Max-Westerman/Integration-Final-Report/main.tex

\documentclass[11pt]{report}
\usepackage{StyleSheets/main}
\makeglossaries               % Only makes glossary in main file
\usetikzlibrary{external}     % Allows for cached complitation
\tikzexternalize[prefix=Graphs/tikz/] % Sets cache directory
\begin{document}
\input{Chapters/TitlePage}

% ---------- %

\microtypesetup{protrusion=false} % Kerning disabled
\singlespacing
\tableofcontents
\listoffigures
\lstlistoflistings
\listoftables
\microtypesetup{protrusion=true} % Kerning Enabled

\newpage
\onehalfspacing

\input{Chapters/Introduction}
\input{Chapters/Project Management Plan}
\input{Chapters/System Requirements}
\input{Chapters/CONOPS}
\input{Chapters/Conceptual Design}
\input{Chapters/System Risk Management}
\input{Chapters/Detailed Design}
\input{Chapters/System Test and Verification}
\input{Chapters/System Analysis}
\input{Chapters/Summary}

\singlespacing
\microtypesetup{protrusion=false} % Kerning disabled
\printglossary[type=\acronymtype]
\input{Chapters/Documentation and Acknowledgements}
\microtypesetup{protrusion=true}  % Kerning Enabled

\appendix
\input{Appendix/Calibration Data}
\input{Appendix/Diagrams}
\input{Appendix/Code}

\end{document}
