Max-Westerman/Integration-Final-Report/Appendix/Diagrams.tex

\documentclass[12pt]{report}
\usepackage{StyleSheets/main}
\begin{document}

\chapter{Diagrams}\label{ap:diagrams}

\section{Robot Designs}
\label{sc:designs}

\begin{figure}[H]
    \centering
    
    \caption{Design 1 Conceptual Design}
    \label{fig:design1}
\end{figure}

\begin{figure}[H]
    \centering
    
    \caption{Design 2 Conceptual Design}
    \label{fig:design2}
\end{figure}

\begin{figure}[H]
    \centering
    
    \caption{Design 3 Conceptual Design}
    \label{fig:design3}
\end{figure}

\begin{figure}[H]
    \centering
    
    \caption{Design 4 Conceptual Design}
    \label{fig:design4}
\end{figure}

\section{Robot Images}

\begin{figure}[H]
    \centering
    
    \caption{Robot front view}
    \label{fig:front-view}
\end{figure}

\begin{figure}[H]
    \centering
    
    \caption{Robot underside}
    \label{fig:underside}
\end{figure}

\begin{figure}[H]
    \centering
    
    \caption{Robot top view}
    \label{fig:topview}
\end{figure}

\section{3D Printed Parts}
\begin{figure}[H]
    \centering
    
    \caption{Front Ultrasonic Sensor Mount}
    \label{fig:USS_front}
\end{figure}
\begin{figure}[H]
    \centering
    
    \caption{Color Sensor \& IR Sensor Mount}
    \label{fig:CS-IR mount}
\end{figure}

\begin{figure}[H]
    \centering
    
    \caption{Gripper Color Sensor Mount}
    \label{fig:GRPR_CS}
\end{figure}

\begin{figure}[H]
    \centering
    
    \caption{Gripper Button Mount}
    \label{fig:GRPR_DualButton}
\end{figure}

\begin{figure}[H]
    \centering
    
    \caption{Ultrasonic Sensor and Color Sensor Mounts}
    \label{fig:USS-CS_Dual}
\end{figure}

\begin{figure}[H]
    \centering
    
    \caption{Cost of first 3D-print}
    \label{fig:printcost1}
\end{figure}

\begin{figure}[H]
    \centering
    
    \caption{Cost of second 3D-print}
    \label{fig:printcost2}
\end{figure}

\begin{figure}[H]
    \centering
    
    \caption{Cost of third 3D-print}
    \label{fig:printcost3}
\end{figure}

\begin{figure}[H]
    \centering
    
    \caption{Cost of the \gls{IR} sensor array}
    \label{fig:enter-label}
\end{figure}

\section{Electrical Diagrams}
\subsection{Circuit Diagram}
\begin{figure}[H]
    \centering
    
    \caption{Circuit Diagram}
    \label{fig:CircuitDiagram}
\end{figure}

\subsection{Pinout Map for Teensy 4.1}
\begin{figure}[H]
    \centering
    
    \caption{Teensy 4.1 Microcontroller Pinout Map}
    \label{fig:Pinoutmap}
\end{figure}

\section{Pickup \& Place Flowchart}\label{sc:pickup-place-flowchart}

\begin{figure}[H]
    \centering
    
    \caption{PID Line Following Function}
    \label{fig:fc:pid_line_following}
\end{figure}

\begin{figure}[H]
    \centering
    
    \caption{Translational Line Centering Function}
    \label{fig:fc:translational-line-centering}
\end{figure}

\begin{figure}[H]
    \centering
    
    \caption{Rotational Line Centering Function}
    \label{fig:fc:rotational-line-centering}
\end{figure}

\begin{figure}[H]
    \centering
    
    \caption{Beginning of Pickup \& Place}
    \label{fig:fc:begin}
\end{figure}

\begin{figure}[H]
    \centering
    
    \caption{Line Orientation Sub Module}
    \label{fig:fc:line-orientation}
\end{figure}

\begin{figure}[H]
    \centering
    
    \caption{Middle Navigation Sub Module}
    \label{fig:fc:middle-navigation}
\end{figure}

\begin{figure}[H]
    \centering
    
    \caption{Fork Navigation Sub Module}
    \label{fig:fc:fork-navigation}
\end{figure}

\begin{figure}[H]
    \centering
    
    \caption{Find Platform Sub Module}
    \label{fig:fc:find-platform}
\end{figure}

\begin{figure}[H]
    \centering
    
    \caption{Navigate Back to Fork Sub Module}
    \label{fig:fc:navigate-back-to-fork}
\end{figure}

\begin{figure}[H]
    \centering
    
    \caption{Return Home Sub Module}
    \label{fig:fc:return-home}
\end{figure}

\newpage\section{Pickup-and-Place Line Course}
\begin{figure}[H]
    \centering
    
    \caption{Pickup-and-Place course.\protect\footnotemark}
    \label{fig:pickup-place-course}
\end{figure}
\footnotetext{Note that within the vertical, green lines are the boundaries of the randomized region of the course.}

\end{document}

    
    \caption{Circuit Diagram}
