Max-Westerman/Integration-Final-Report/Chapters/TitlePage.tex

\documentclass[11pt]{report}
\usepackage{StyleSheets/main}
\usetikzlibrary{external}     % Allows for cached complitation
\tikzexternalize[prefix=Graphs/tikz/] % Sets cache directory

\begin{document}

\begin{titlepage}

    \tikzset{external/export next=false} % Exclude from externalization
    \begin{tikzpicture}[remember picture, overlay]
        \node[anchor=south east, inner sep=0, opacity=0.1, xshift=100mm, yshift=35mm] at (current page.south east) {
              % Adjust only width or height
        };
    \end{tikzpicture}
    
    \centering
    
    \Large{ENGR 2620}
    
    \Large{Integration II}
    
    \Large{Spring 2024}

    \vspace{0.5cm}
    
    \Huge \textsc{\TITLENAME}

    \vfill
    
    \vspace{1cm}
    
    \large{Dr. Jide Williams} \\
    \large{Dr. Irwin Jones}
    
    \vspace{0.8cm}

    \large \textbf{Prepared By:}
    \hspace{1.3cm} \begin{tabular}[t]{@{}l@{}}
        \textbf{Max Westerman}\\
        \textbf{Daniel Carey}\\
        \textbf{Charlie Buttrick}\\
        \textbf{Dylan Wright}\\
    \end{tabular}
    \vspace{10pt}
    
    \vfill
    \hfill \large Report Grade: \underline{\hspace{4cm}}
        
\end{titlepage}

\end{document}

    \begin{tikzpicture}[remember picture, overlay]
        \node[
            anchor=north west,
            fill=gray!20,
            minimum width=\paperwidth,
            minimum height=4cm,
            yshift=-17.35cm,
            xshift = 10.7cm
        ] at (current page.north west) {};
    \end{tikzpicture}
