Max-Westerman/Integration-Final-Report/Chapters/Project Management Plan.tex

\documentclass[11pt]{report}
\usepackage{StyleSheets/main}

\begin{document}

\SectionuseSubSectionSizing
\SubSectionuseSubSubSectionSizing
\setlength{\parindent}{0pt} % Disables indentation

\chapter{Project Management Plan}\label{ch:project-management-plan}

\section{Week 1 (4/1/24 - 4/7/24)}
\begin{adjustwidth}{0.5cm}{0cm}
\subsection*{4/4}
\begin{greylineformat}
\begin{description}
    \item [50 minutes] Danny Carey and Charlie Buttrick looked over the provided kits and used the material checklist to verify all materials for the project were missing.
    \item [25 minutes] Danny Carey and Charlie Buttrick test ultrasonic sensors.
\end{description}\end{greylineformat}

\begin{description}
    \item [Weekly Summary:] Provided kits were checked and materials were verified. Ultrasonic Sensors were tested. Our objectives for next week will be to meet with Carter Sorenson and begin to talk about ideas for the obstacle test.
\end{description}\vspace{0.5em}
\end{adjustwidth}

\section{Week 2 (4/8/24 - 4/14/24)}
\begin{adjustwidth}{0.5cm}{0cm}
\subsection*{4/8}
\begin{greylineformat}
\begin{description}
    \item [25 minutes]Danny Carey, Charlie Buttrick, and Max Westerman met to discuss the outline of the code. The idea to use classes was commonly agreed it would be most efficient due to making troubleshooting easier.
\end{description}\end{greylineformat}

\vspace{-2.1em}\subsection*{4/11}
\begin{greylineformat}
\begin{description}
    \item [60 minutes]Charlie Buttrick and Max Westerman met with Carter Sorenson for advice on the overall strategy of the project. The meeting also covered the subject of \gls{PID} controllers.
    \item [1 hour and 30 minutes]Charlie Buttrick worked on pseudo-code for the obstacle test.
    \item [1 hour]Danny Carey began to work on the gripper, specifically a prototype design.
    \item [1 hour] Danny Carey and Max Westerman brainstormed ideas for the overall design of the vehicle, with a targeted focus on wheel placement.
\end{description}\end{greylineformat}

\begin{description}
    \item [Weekly Summary:]The outline of the code was decided on. A project strategy was created, and \gls{PID} controllers were discussed. Pseudo-code written for obstacle test. A gripper prototype was designed. Wheel placement was discussed. Our objectives for next week will be to begin the design of the vehicle and simple movement testing.
\end{description}
\end{adjustwidth}\vspace{0.5em}

\section{Week 3 (4/15/24 - 4/21/24)}
\begin{adjustwidth}{0.5cm}{0cm}
\subsection*{4/15}
\begin{greylineformat}
\begin{description}
    \item [35 minutes] Max Westerman worked on color sensors and added debug statements. 
    \item [1 hour and 45 minutes] Danny Carey and Max Westerman assembled wheels, motor controllers, and Teensy 4.1 board for design 1. 
\end{description}\end{greylineformat}

\vspace{-2.1em}\subsection*{4/16}
\begin{greylineformat}
\begin{description}
    \item [1 hour] Max Westerman ran a motor test for design 1. 
    \item [25 minutes] Max Westerman tested the resistance of black and silver screws that will be used to connect the battery and motor controller. 
\end{description}\end{greylineformat}

\vspace{-2.1em}\subsection*{4/18}
\begin{greylineformat}
\begin{description}
    \item [1 hour and 30 minutes] Danny Carey continued work on the gripper arm and began to add wiring. 
    \item [1 hour] Charlie Buttrick and Max Westerman brainstormed ideas for code of the obstacle course and the location of the ultrasonic sensors on the vehicle. 
    \item [30 minutes] Charlie Buttrick and Max Westerman thought of ideas to fix side wheels that were stalling on forward movement. 
\end{description}\end{greylineformat}

\begin{description}
    \item [Weekly Summary:]Debug statements added to code. Wheels assembled with motor controllers and Teensy 4.1 for design 1. Motor test conducted. Resistance of screws tested for battery connection. Gripper wiring added. Obstacle code and ultrasonic sensor location discussed. Ideas to fix side wheels that were stalling generated. Our objectives for next week will be to work on our detailed design presentation and continue to build system, specifically the placement of the ultrasonic sensors.
\end{description}\vspace{0.5em}
\end{adjustwidth}

\section{Week 4 (4/22/24 - 4/28/24)}
\begin{adjustwidth}{0.5cm}{0cm}
\subsection*{4/23}
\begin{greylineformat}
\begin{description}
    \item [1 hour] Danny Carey and Charlie Buttrick began to work on detailed design review. 
    \begin{dash-itemize}
        \item Charlie Buttrick focused more on customer requirements, the project management plan, the purpose, and the current state of the project.
        \item Danny Carey focused on the project design outline, the design matrix, and the current state of the project.
    \end{dash-itemize}
\end{description}\end{greylineformat}

\vspace{-2.1em}\subsection*{4/25}
\begin{greylineformat}
\begin{description}
    \item [35 minutes] Danny Carey and Charlie Buttrick moved ultrasonic sensors to the front of the vehicle. 
    \item [30 minutes] Danny Carey and Charlie Buttrick added washers to the side wheels to try to fix the side wheels from stalling. 
    \item [35 minutes] Danny Carey and Charlie Buttrick took apart Design 1, specifically the wiring and placement of the battery. The motor controllers and wheels are still intact. 
    \item [20 minutes] Dylan Wright, Danny Carey, and Charlie Buttrick gave detailed design review presentation.
\end{description}\end{greylineformat}

\begin{description}
    \item [Weekly Summary:] Detailed design review started. Ultrasonic sensors are placed in front of vehicles. Washers were placed under side wheels to try to fix stalling. Design 1 deconstructed (wiring/battery). Detailed design presentation takes place and feedback is given. Our objectives for next week will be to begin writing the obstacle code and discuss the line following code.
\end{description}\vspace{0.5em}
\end{adjustwidth}

\section{Week 5 (4/29/24 - 5/5/24)}
\begin{adjustwidth}{0.5cm}{0cm}
\subsection*{4/30}
\begin{greylineformat}
\begin{description}
    \item [1 hour] Charlie Buttrick and Max Westerman met to discuss and begin code for obstacle course test, specifically adding classes to the code for more scenarios. 
    \item [30 minutes] Charlie Buttrick and Max Westerman discussed the line following code. 
\end{description}\end{greylineformat}

\vspace{-2.1em}\subsection*{5/2}
\begin{greylineformat}
\begin{description}
    \item [2 hours] It was discovered that after Design 1 was taken apart, multiple wire tips were disconnected and broken.
    \begin{dash-itemize}
        \item Charlie Buttrick tried to solder back one wire to the motor and accidentally burned the motor. The team bought a new motor.
        \item Max used equipment in the innovation lab to solder back the wires to the motors and motor controllers.
    \end{dash-itemize}
    \item [1 hour] Charlie Buttrick added to the ultrasonic code. 
    \item [1 hour and 30 minutes] Danny Carey began to build Design 2, focused on the placement of the battery and Teensy 4.1 board. Also, added wiring for the Teensy 4.1 board and battery. 
\end{description}\end{greylineformat}

\vspace{0.1em}\begin{description}
    \item [Weekly Summary:] Obstacle avoidance and line following code discussed. Multiple damages and breakages were discovered after Design 1 was deconstructed. Soldering was attempted but the motor broke. New motor was burnt and the innovation lab was used to solder wires. Ultrasonic code improved. Design 2 was built, battery placement and Teensy 4.1 placement and wiring focus. Our objectives for next week will be to test our obstacle avoidance code and make progress with building the gripper. Another objective will be to complete the gripper wiring for the gripper and test design 2 on the obstacle course.
\end{description}\vspace{0.5em}
\end{adjustwidth}

\section{Week 6 (5/6/24 - 5/12/24)}
\begin{adjustwidth}{0.5cm}{0cm}
\subsection*{5/7}
\begin{greylineformat}
\begin{description}
    \item [30 minutes] Charlie Buttrick, Danny Carey, and Max Westerman combined the motor controller plate and battery/Teensy 4.1 board plate. 
    \item [30 minutes] Charlie Buttrick, Danny Carey, and Max Westerman placed sensor mounts on the front of the vehicle and attached ultrasonic sensors. 
    \item [25 minutes] Charlie Buttrick and Max Westerman verified the ultrasonic sensor code. 
\end{description}\end{greylineformat}

\vspace{-2.1em}\subsection*{5/9}
\begin{greylineformat}
\begin{description}
    \item [1 hour and 40 minutes] Charlie Buttrick, Danny Carey, Dylan Wright, and Max Westerman tested the obstacle test. 
\end{description}\end{greylineformat}

\vspace{-2.1em}\subsection*{5/10}
\begin{greylineformat}
\begin{description}
    \item [1 hour and 40 minutes] Danny Carey and Max Westerman completed the wiring for the gripper. 
\end{description}\end{greylineformat}

\vspace{-2.1em}\subsection*{5/12}
\begin{greylineformat}
\begin{description}
    \item [1 hour and 30 minutes] Charlie Buttrick and Max Westerman tried to fix the side wheels' stalling issue by adding heavy mass to the vehicle. 
    \item [10 minutes] Charlie Buttrick, Danny Carey, and Max Westerman decided to take apart Design 2.
    \item [1 hour] Danny Carey builds customized sensor mounts in SolidWorks. 
    \item [1 hour] Max Westerman takes apart all of Design 2 except the motor controller and wheel placement and wires. 
    \item [35 minutes] Charlie Buttrick and Max Westerman think about the idea of IR sensors. 
\end{description}\end{greylineformat}

\newpage
\begin{description}
    \item [Weekly Summary:]Motor controller plate and battery/Teensy 4.1 plate combined. Sensor mounts and ultrasonic sensors are attached. Ultrasonic sensor code verified. Obstacle course run tested. Wiring for gripper completed. Heavy mass was added to the vehicle to fix the side wheels stalling. Design 2 taken apart. Customized sensor mounts built in SolidWorks. \gls{IR} sensor idea discussed. Our objectives for next week will be to test redesign Design 3 as well as test the gearboxes to see if they will or will not impact the speed. Also, sensor mounts will be printed for the ultrasonic sensors. We will also want to finish the line following code and begin testing and implement the \gls{IR} Array.
\end{description}\vspace{0.5em}
\end{adjustwidth}

\section{Week 7 (5/13/24 - 5/19/24)}
\begin{adjustwidth}{0.5cm}{0cm}
\subsection*{5/13}
\begin{greylineformat}
\begin{description}
    \item [10 minutes] Danny Carey 3-D prints sensor mounts for Design 3. 
    \item [30 minutes] Max Westerman tests the compatibility of gearboxes for torque motors. It is deemed successful thus 2 motors of the vehicle are replaced. 
    \item [3 hours] Max Westerman machined down a dead torque motor gearbox. This verified that the torque motor would be faster when modified. 
\end{description}\end{greylineformat}

\vspace{-2.1em}\subsection*{5/14}
\begin{greylineformat}
\begin{description}
    \item [2 hours and 30 minutes] Danny Carey and Max Westerman assembled Design 3, the plate with the motor controllers and wheels are attached to the plate with the Teensy 4.1 board as well as the battery. 
\end{description}\end{greylineformat}

\vspace{-2.1em}\subsection*{5/16}
\begin{greylineformat}
\begin{description}
    \item [40 minutes] Danny Carey attaches the customized sensor mounts to the vehicle and the color and ultrasonic sensors are attached. 
    \item [1 hour and 30 minutes] Charlie Buttrick, Dylan Wright, Danny Carey, and Max Westerman test Design 3 on the obstacle test. 
    \item [35 minutes] Charlie Buttrick and Max Westerman test the basic line following code. 
    \item [1 hour] Danny Carey designed a sensor mount for the bottom of the vehicle. 
\end{description}\end{greylineformat}

\vspace{-2.1em}\subsection*{5/19}
\begin{greylineformat}
\begin{description}
    \item [1 hour] Danny Carey and Max Westerman attach the gripper to the vehicle. 
    \item [1 hour and 30 minutes] Danny Carey and Max Westerman attach an \gls{IR} array and color sensor to the sensor mount on the bottom of the vehicle. 
\end{description}\end{greylineformat}

\newpage
\begin{description}
    \item [Weekly Summary:]Sensor mounts for Design 3 printed. Compatibility of gearboxes for torque motors tested. 2 motors are replaced. Design 3 is assembled. Sensor mounts are attached. Design 3 tested on an obstacle test. Basic line following code tested. Sensor mount for bottom of vehicle designed. Gripper attached to the vehicle. \gls{IR} and color sensor attached to the vehicle. Our objectives for next week will be to clean up the wiring of the system, add pushbuttons to the end of the gripper arm, continue obstacle testing, test the line following code and improve the vehicle’s ability to follow the line as needed.
\end{description}\vspace{0.5em}
\end{adjustwidth}

\section{Week 8 (5/20/24 - 5/26/24)}
\begin{adjustwidth}{0.5cm}{0cm}
\subsection*{5/20}
\begin{greylineformat}
\begin{description}
    \item [1 hour and 20 minutes] Danny Carey and Max Westerman rewired the color sensors, the gripper, the \gls{IR} array, and the ultrasonic sensor. 
    \item [30 minutes] Danny Carey and Max Westerman implemented, coded, and wired the button toggle for the gripper. 
    \item [1 hour and 30 minutes] Danny Carey and Max Westerman secured the plastic gripper gear via reversible super glue and lock tight. 
    \item [1 hour] Max Westerman coded the gripper pick-up and place schema and tested. The middle color sensor is burnt.
    \item [2 hours] Max Westerman tested obstacle avoidance. 
    \item [3 hours] Max Westerman designed and implemented a suspension system on the vehicle. 
\end{description}\end{greylineformat}

\vspace{-2.1em}\subsection*{5/21}
\begin{greylineformat}
\begin{description}
    \item [1 hour and 25 minutes] Max Westerman implemented the suspension system. 
    \item [1 hour] Max Westerman and Charlie Buttrick began to code the \gls{IR} array algorithm as well as brainstorm how to implement \gls{PID} logic. 
    \item [1 hour and 10 minutes] Max Westerman worked on pick-up and placement code for the system. 
    \item [45 minutes] Danny Carey redesigned sensor mounts for the front of the vehicle after it was discovered it cracked. 
    \item [2 hours] Max Westerman and Charlie Buttrick worked on and tested the line following code. 
    \item [25 minutes] Danny Carey replaced the middle burnt color sensor. 
\end{description}\end{greylineformat}

\vspace{-2.1em}\subsection*{5/22}
\begin{greylineformat}
\begin{description}
    \item [1 hour] Danny Carey designed a mount for the end of the gripper arm via SolidWorks. 
    \item [2 hours] Danny Carey and Max Westerman continued to wire the gripper as sensors and pushbuttons were being added. 
\end{description}\end{greylineformat}

\vspace{-2.1em}\subsection*{5/23}
\begin{greylineformat}
\begin{description}
    \item [1 hour] Danny Carey and Charlie Buttrick attached a new sensor mount to the bottom side of the front end of the vehicle. 
    \item [1 hour and 30 minutes] Max Westerman color-calibrated the \gls{IR} array and updated the code. 
    \item [25 minutes] Max Westerman wired the sensor mount on the bottom side of the front end of the vehicle. 
    \item [15 minutes] Max Westerman added a vertical box length variable to the pickup and placement code to help center the vehicle. 
    \item [25 minutes] Max Westerman improved the color sensor calibration for the front-end sensors of the vehicle. 
\end{description}\end{greylineformat}

\vspace{-2.1em}\subsection*{5/24}
\begin{greylineformat}
\begin{description}
    \item [45 minutes] Max Westerman completed the \gls{IR} array code with a calibrated error. 
    \item [1 hour] Max Westerman tested the \gls{IR} array code to make sure if the vehicle deviates from the line, it will correctly realign with the line. 
    \item [45 minutes] Max Westerman added an \gls{LED} feature that connects to the battery being turned on. 
\end{description}\end{greylineformat}

\begin{description}
    \item [Weekly Summary:]Gripper, color sensors, \gls{IR} array, and ultrasonic sensor rewired. A pushbutton for the gripper was added, wired, and coded. The \gls{IR} array was tested and completed. Our objectives for next week will be to test the gripper arm and test the full pick up and placement course.
\end{description}\vspace{0.5em}
\end{adjustwidth}

\section{Week 9 (5/27/24 - 6/2/24)}
\begin{adjustwidth}{0.5cm}{0cm}
\subsection*{5/27}
\begin{greylineformat}
\begin{description}
    \item [2 hours] Max Westerman and Danny Carey test gripper arm. 
    \item [1 hour] Danny Carey designs a sensor mount for the ultrasonic sensor that will be put on the front of the vehicle. 
\end{description}\end{greylineformat}

\vspace{-2.1em}\subsection*{5/28}
\begin{greylineformat}
\begin{description}
    \item [1 hour] Max Westerman and Charlie Buttrick calibrate, wire, and mount the ultrasonic sensor to the 3-D printed sensor mount. 
    \item [1 hour and 45 minutes] Max Westerman, Danny Carey, and Charlie Buttrick test the full line following and pickup and placement test. 
\end{description}\end{greylineformat}

\subsection*{5/30}
\begin{greylineformat}
\begin{description}
    \item [1 hour] Max Westerman ensures the obstacle avoidance logic \& calibration is finalized for the final test.
    \item [25 minutes] Charlie Buttrick, Danny Carey, Max Westerman, and Dylan Wright test vehicle on obstacle course and the test is deemed complete.
    \item [30 minutes] Charlie Buttrick, Danny Carey, Max Westerman, and Dylan Wright brainstorm ideas of how to fix the pickup and place test which is stemming from an ultrasonic sensor issue. 
\end{description}\end{greylineformat}

\vspace{-2.1em}\subsection*{6/2}
\begin{greylineformat}
\begin{description}
    \item [2 hours and 30 minutes] Charlie Buttrick, Danny Carey, and Max Westerman improve color calibration of all sensors and alter ultrasonic sensor code. 
    \item [1 hour] Danny Carey and Max Westerman test line following and pick up and placement test and were able to get consecutive successful tests. 
\end{description}\end{greylineformat}

\begin{description}
    \item [Weekly Summary:]The gripper arm is tested and the tests are deemed successful. An ultrasonic sensor is added. The obstacle test was completed. Our objectives for next week will be to test the pickup and placement test to get a complete test.
\end{description}\vspace{0.5em}
\end{adjustwidth}

\section{Week 10 (6/3/24 - 6/9/24)}
\begin{adjustwidth}{0.5cm}{0cm}
\subsection*{6/3}
\begin{greylineformat}
\begin{description}
    \item [1 hour] Max Westerman ensures the pickup \& place logic, and the calibration is finalized for the final test.
    \item [15 minutes] Charlie Buttrick, Danny Carey, Max Westerman, and Dylan Wright test vehicle on line following and pickup and placement course and the test is deemed complete.
    \item [25 minutes] Danny Carey and Dylan Wright take apart vehicle. 
\end{description}\end{greylineformat}
\end{adjustwidth}

\SectionuseNormalSectionSizing
\SubSectionuseNormalSectionSizing

\end{document}
