Max-Westerman/Integration-Final-Report/Images/Designs/Design1a.pdf

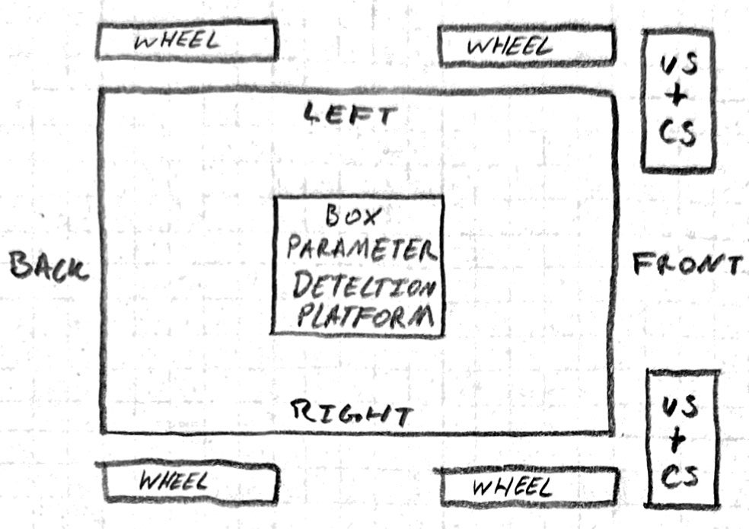
[picture p1: page 1]
