Max-Westerman/Integration-Final-Report/Images/Designs/Design1b.pdf

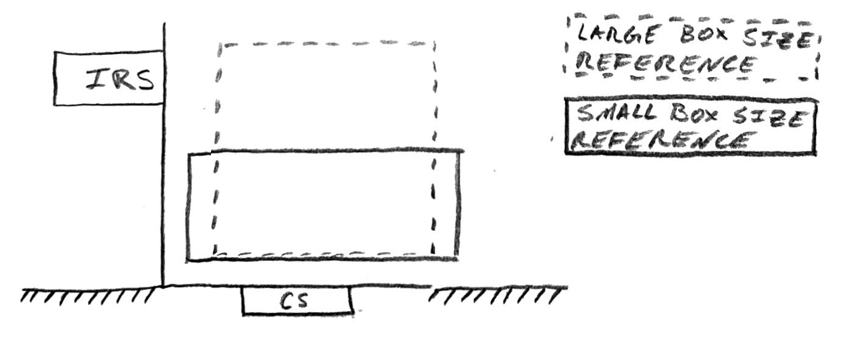
[picture p2: page 1]
