Max-Westerman/Integration-Final-Report/Images/Designs/Design2a.pdf

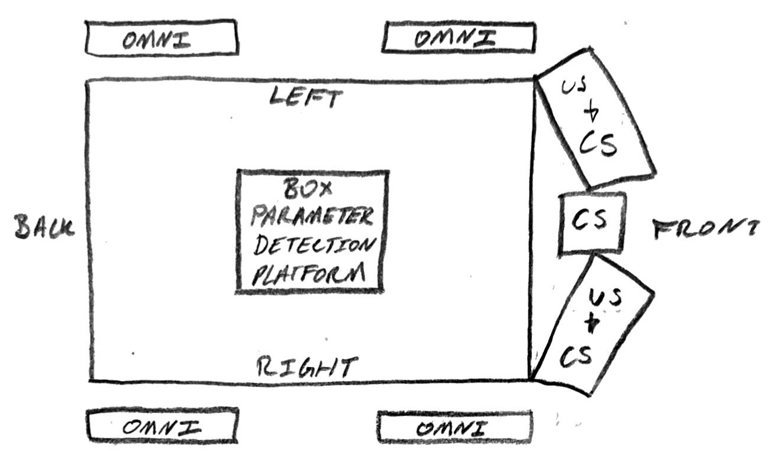
[picture p3: page 1]
