Max-Westerman/Integration-Final-Report/Images/Designs/Design2b.pdf

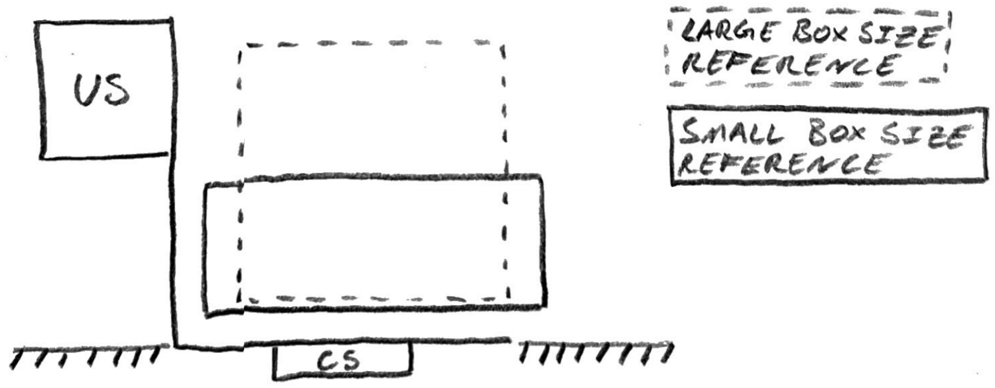
[picture p4: page 1]
