Max-Westerman/Integration-Final-Report/Images/Designs/Design3a.pdf

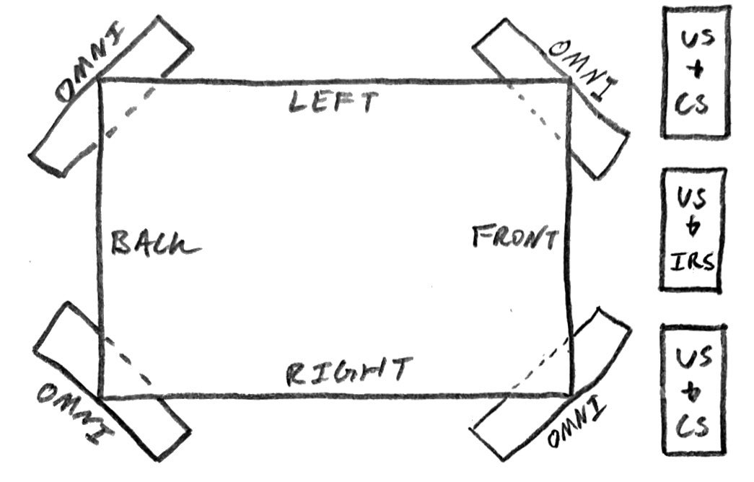
[picture p5: page 1]
