Max-Westerman/Integration-Final-Report/Images/Designs/Design3b.pdf

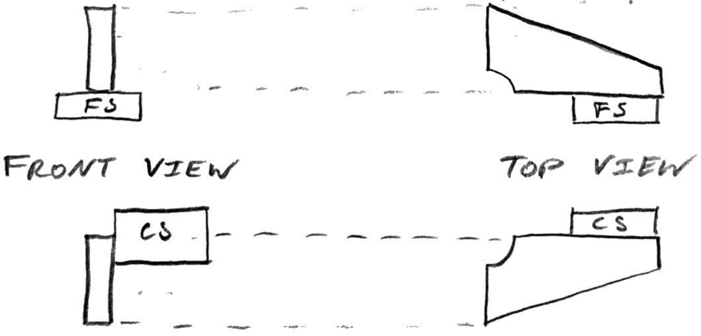
[picture p6: page 1]
