Max-Westerman/Integration-Final-Report/Images/Designs/Design4a.pdf

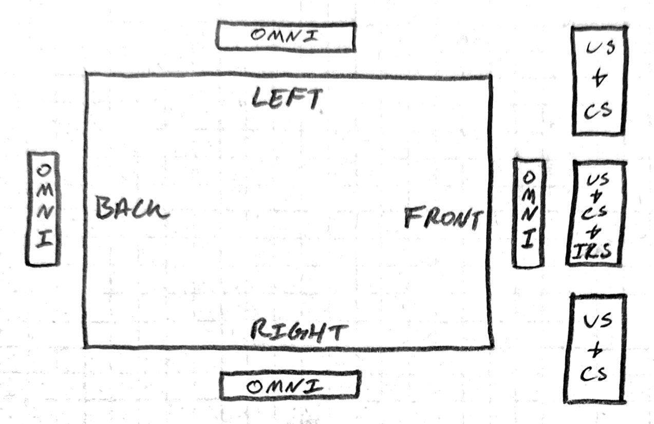
[picture p7: page 1]
