Max-Westerman/Integration-Final-Report/Images/Designs/Design4b.pdf

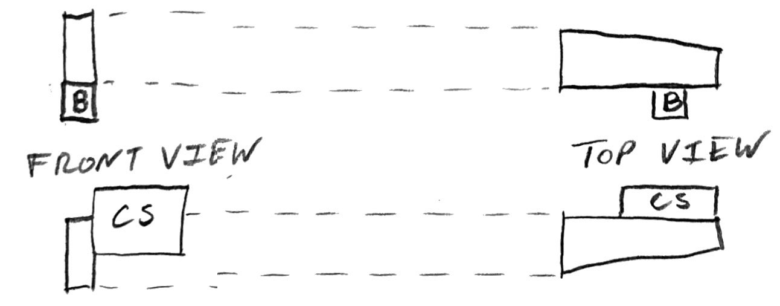
[picture p8: page 1]
