Max-Westerman/Integration-Final-Report/Images/Designs/Design1.pdf

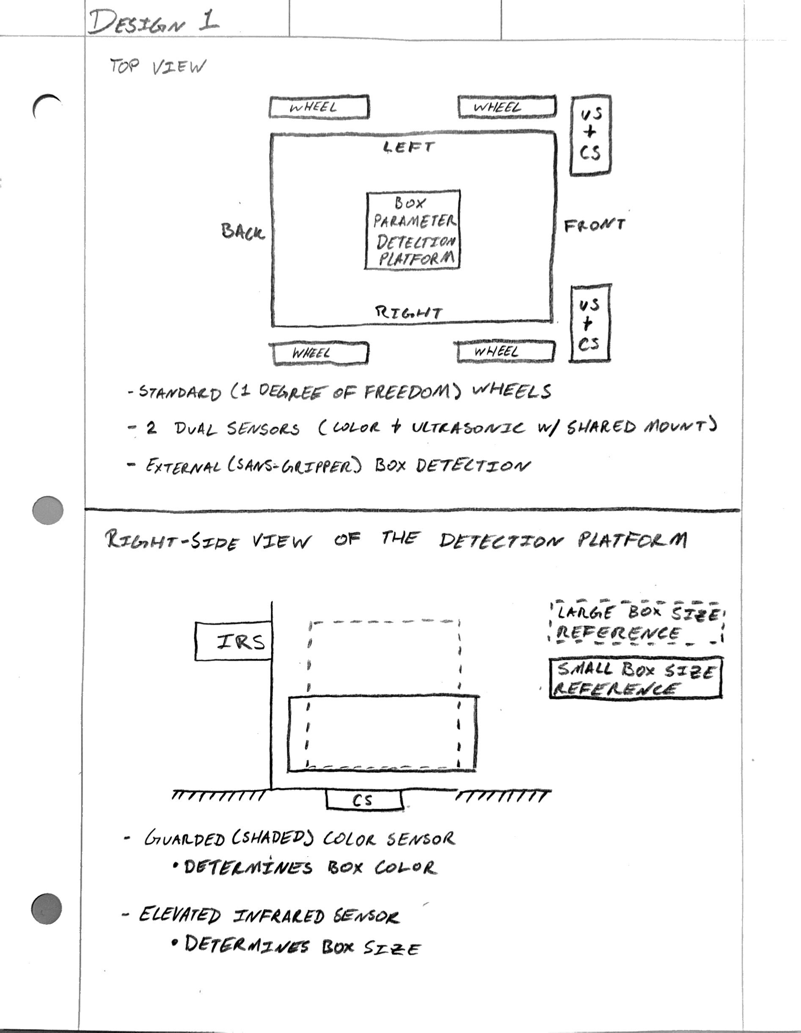
[picture p9: page 1]
