Max-Westerman/Integration-Final-Report/Images/Designs/Design2.pdf

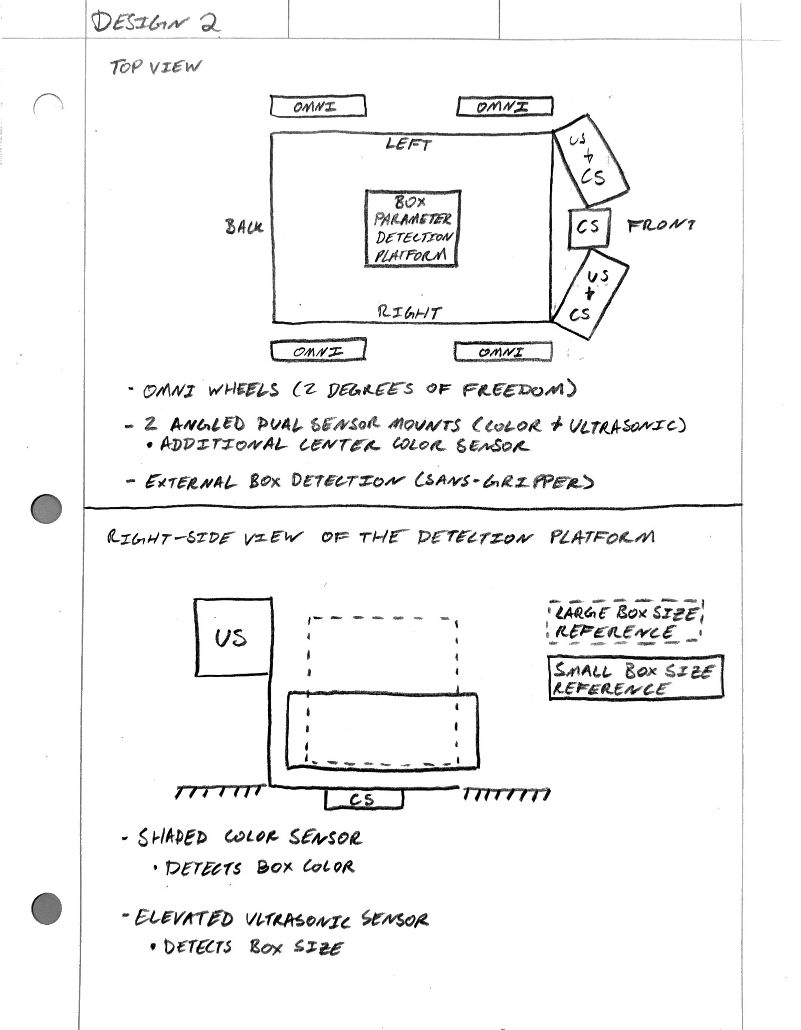
[picture p10: page 1]
