Max-Westerman/Integration-Final-Report/Images/Designs/Design3.pdf

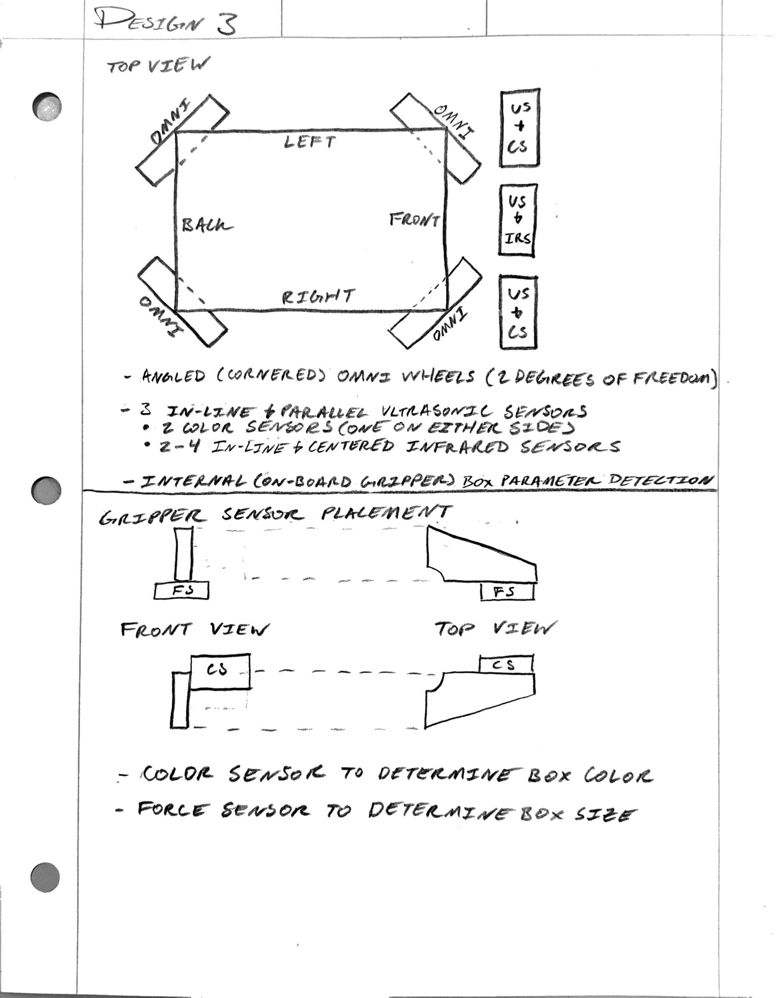
[picture p11: page 1]
