Max-Westerman/Integration-Final-Report/Images/Designs/Design4.pdf

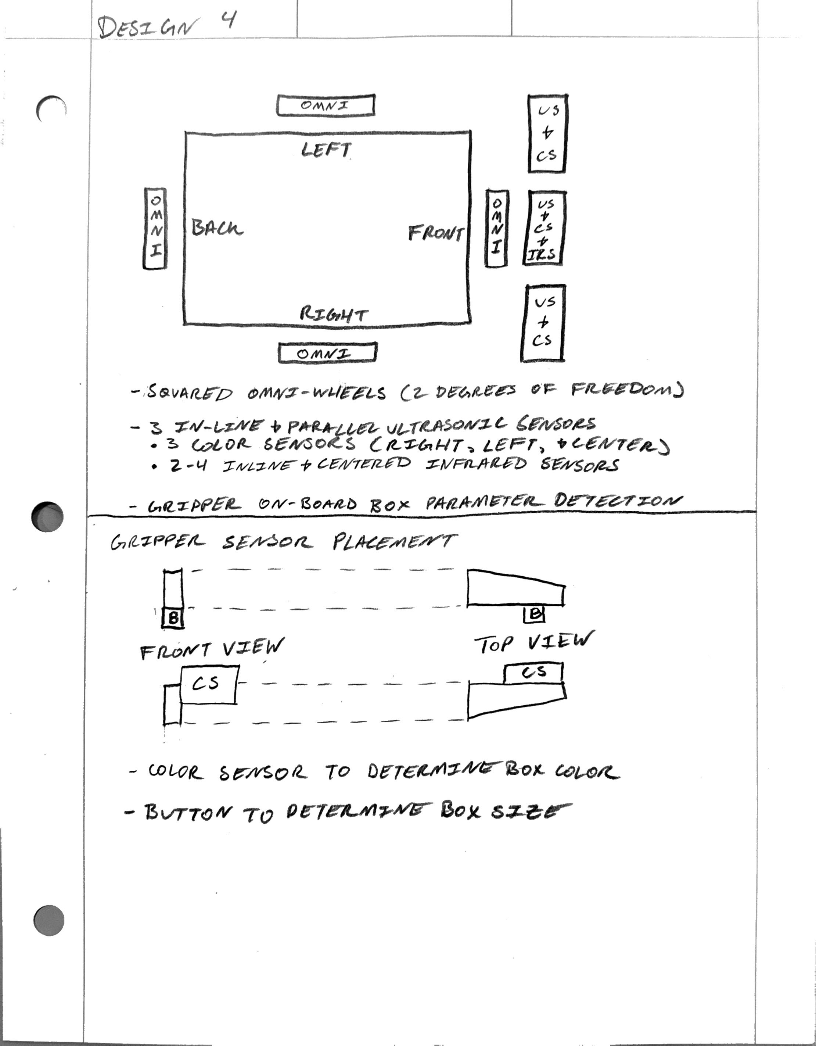
[picture p12: page 1]
