Max-Westerman/Integration-Final-Report/Images/Diagrams/pickup_place_course.pdf

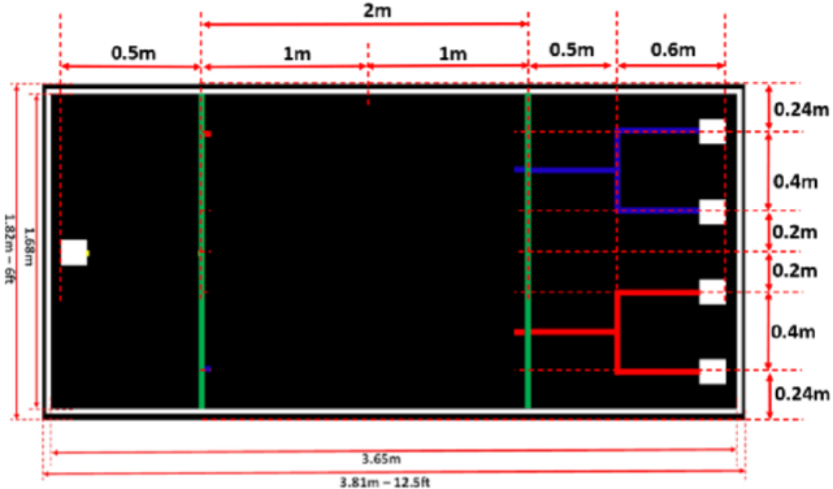
[picture p13: page 1]
