Max-Westerman/Integration-Final-Report/Images/flowchart/begin.pdf

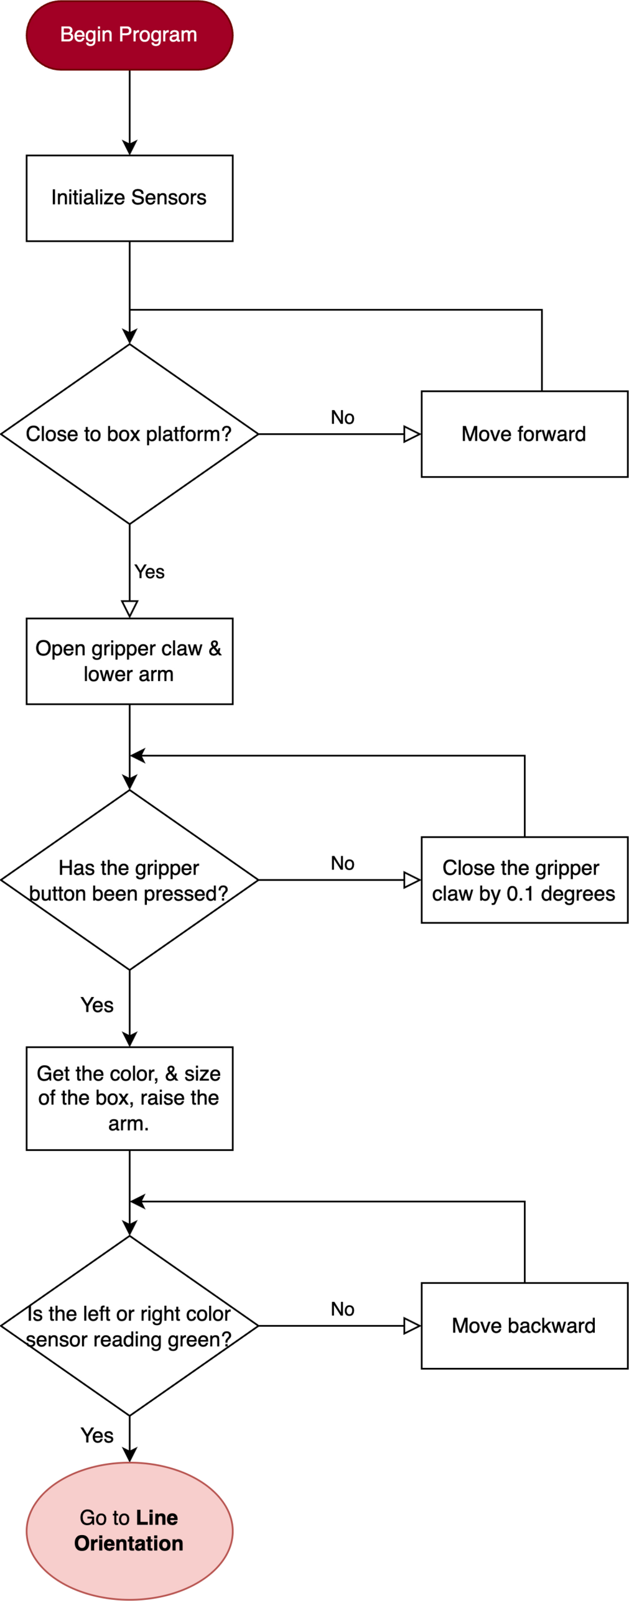
[picture p14: page 1]
