Max-Westerman/Integration-Final-Report/Images/flowchart/find_platform.pdf

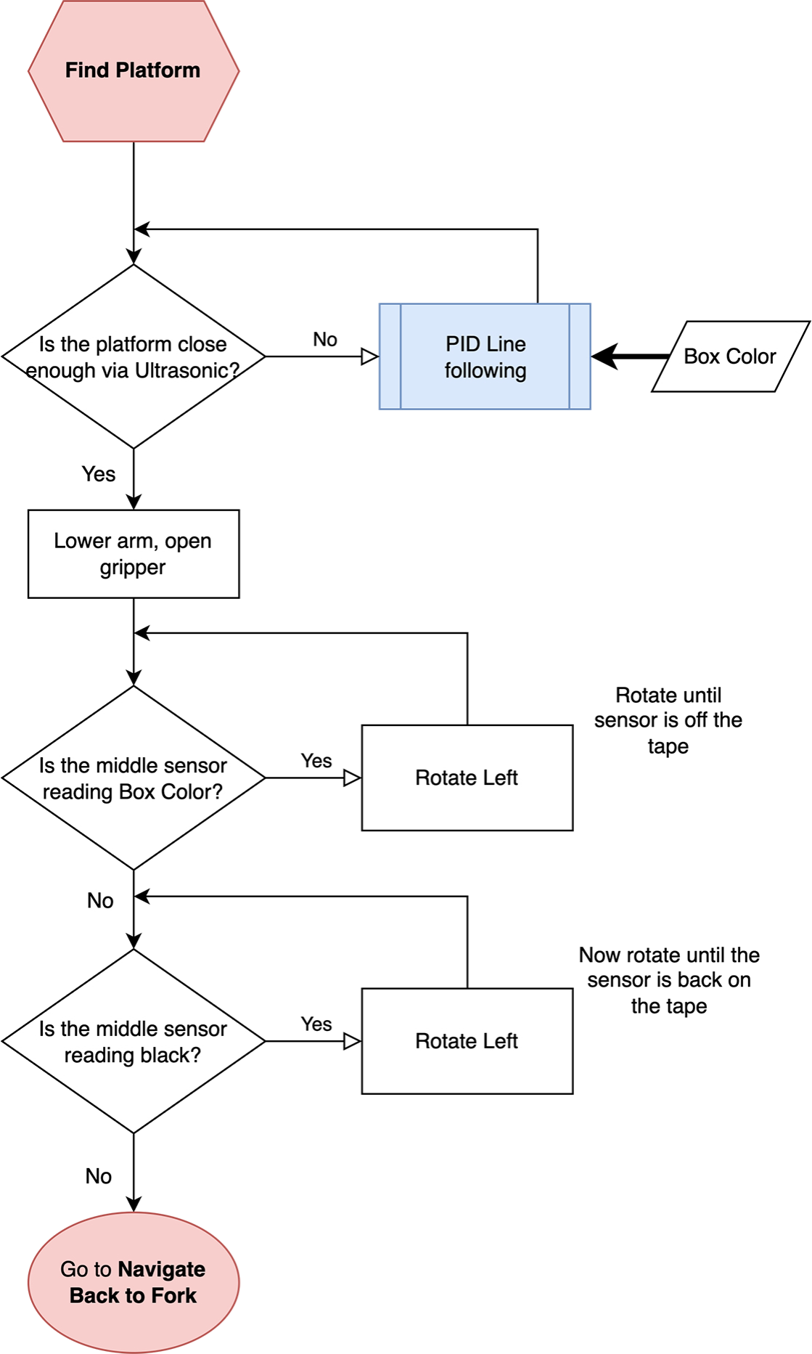
[picture p15: page 1]
