Max-Westerman/Integration-Final-Report/Images/flowchart/fork_navigation.pdf

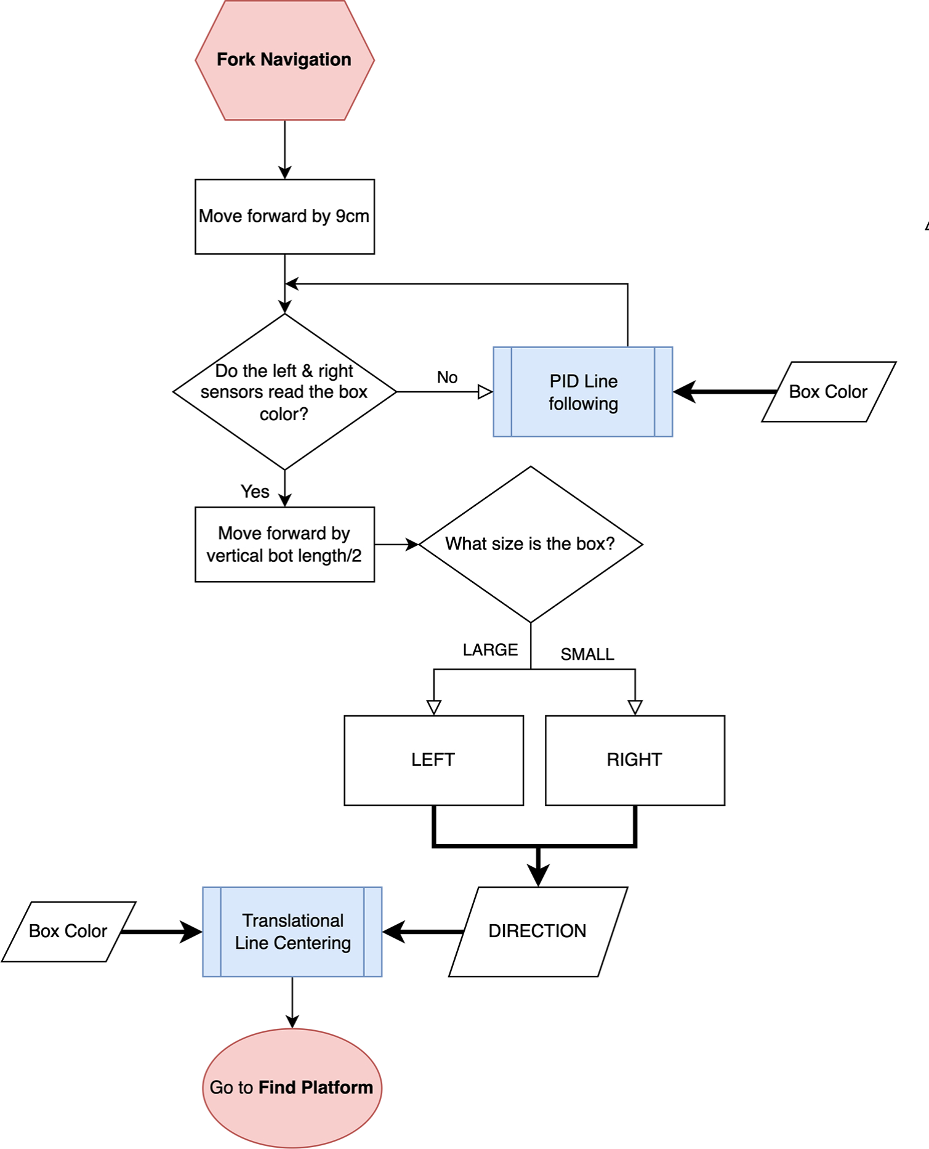
[picture p16: page 1]
