Max-Westerman/Integration-Final-Report/Images/flowchart/line_orientation.pdf

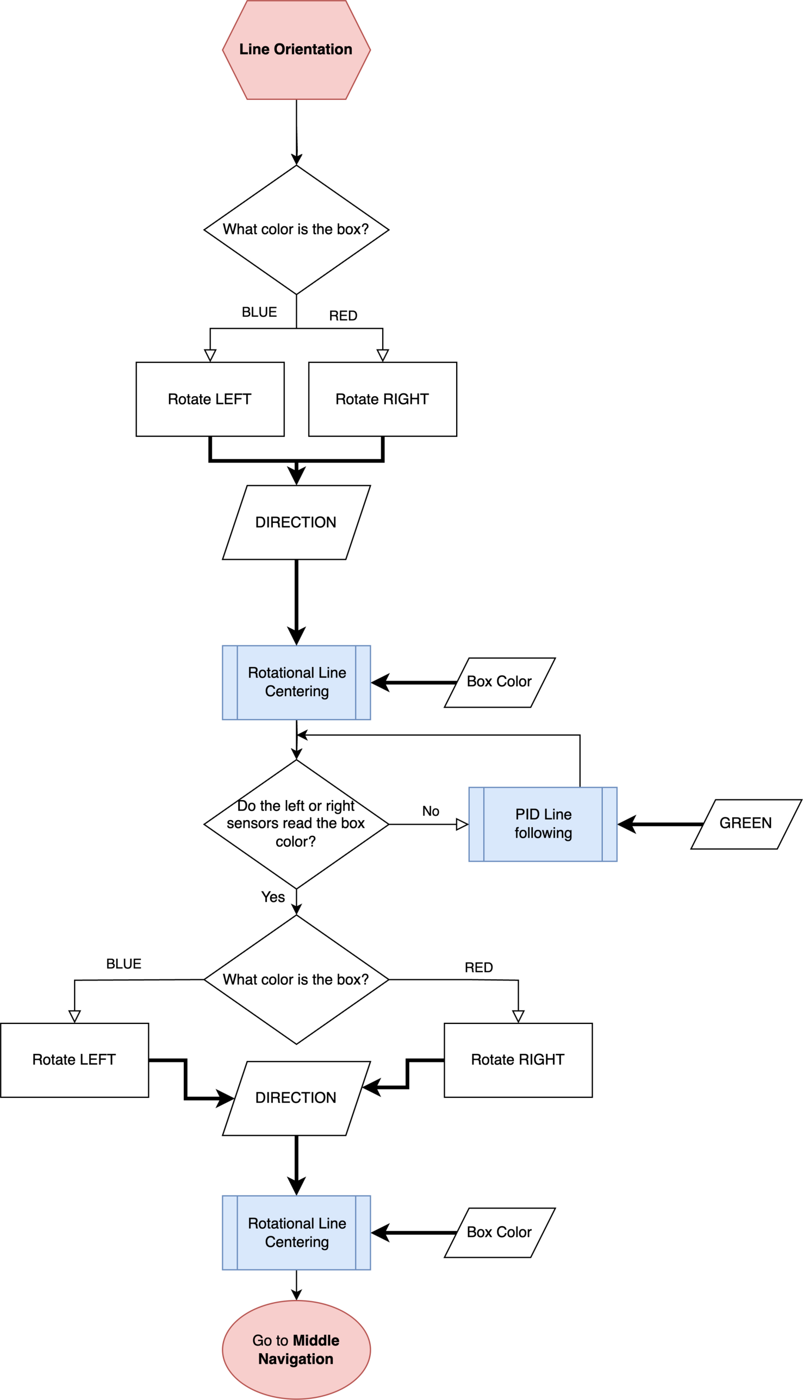
[picture p17: page 1]
