Max-Westerman/Integration-Final-Report/Images/flowchart/middle_navigation.pdf

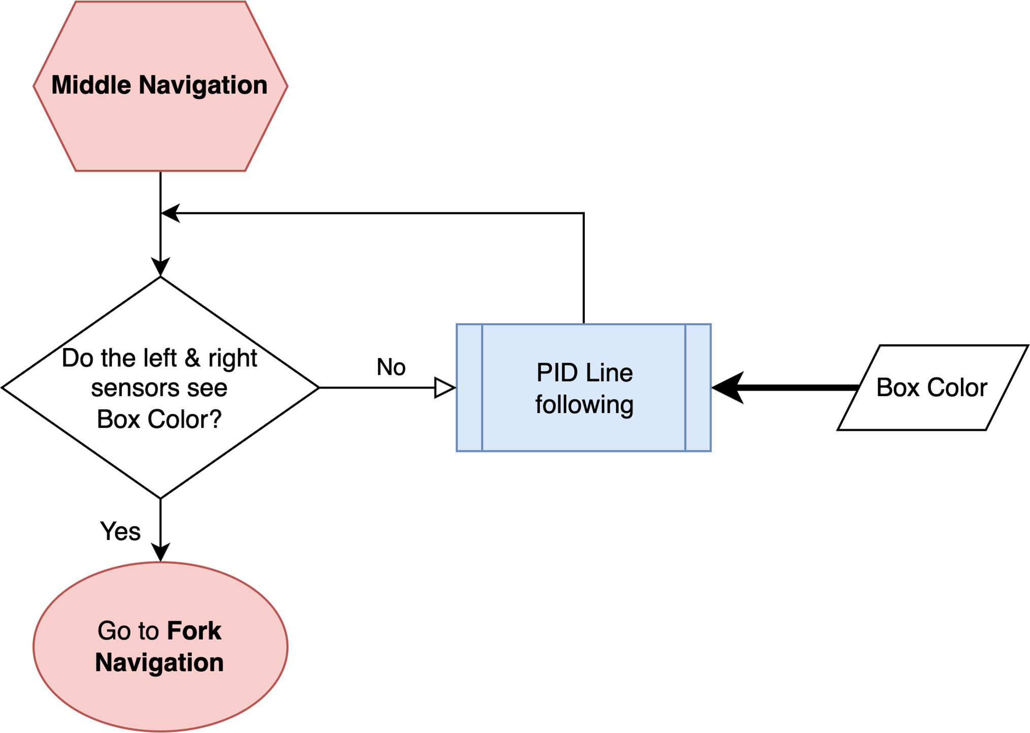
[picture p18: page 1]
