Max-Westerman/Integration-Final-Report/Images/flowchart/navigate_back_to_fork.pdf

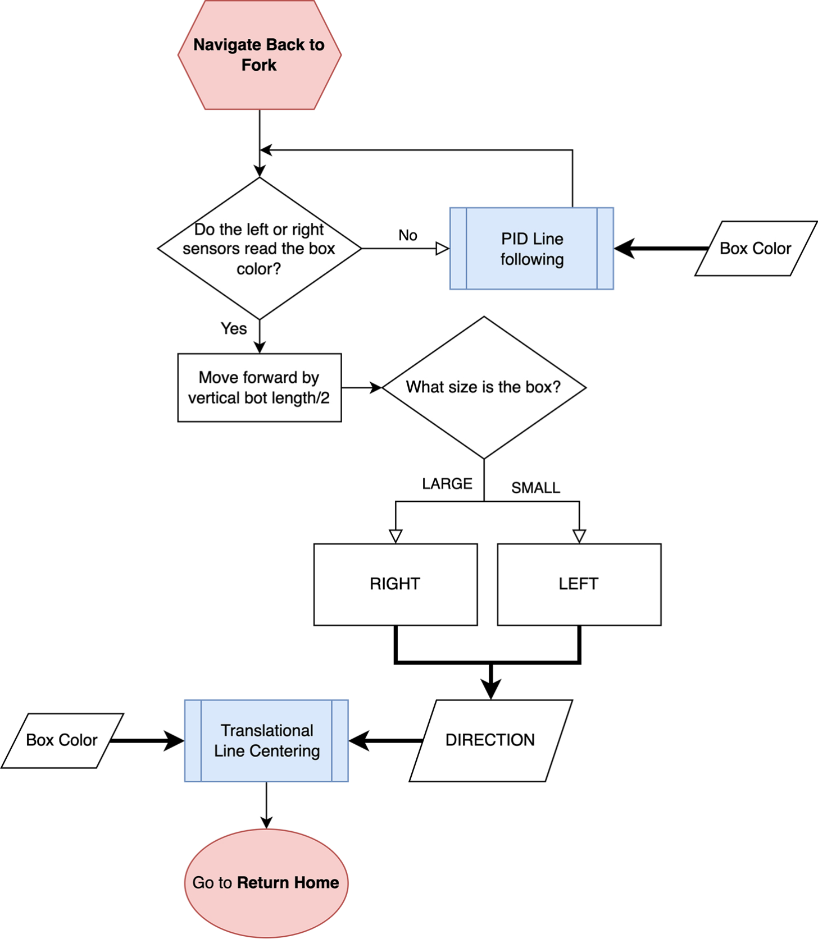
[picture p19: page 1]
