Max-Westerman/Integration-Final-Report/Images/flowchart/pid_line_following.pdf

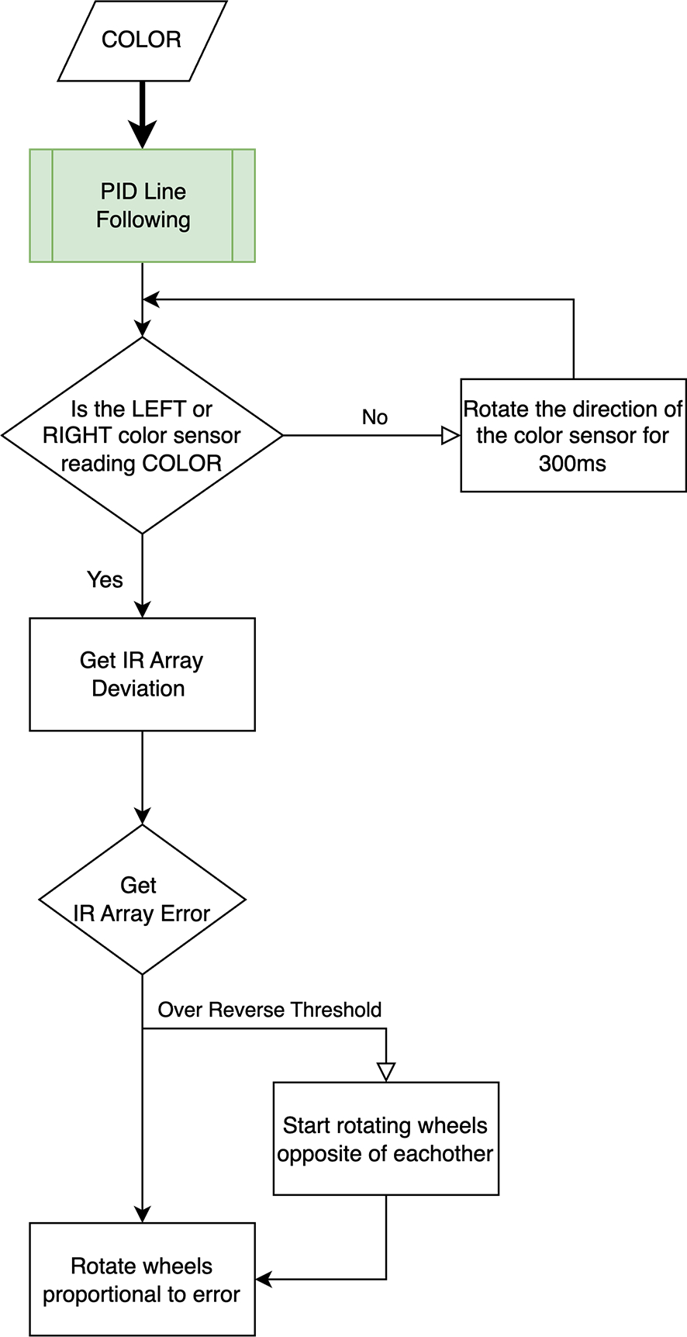
[picture p20: page 1]
