Max-Westerman/Integration-Final-Report/Images/flowchart/return_home.pdf

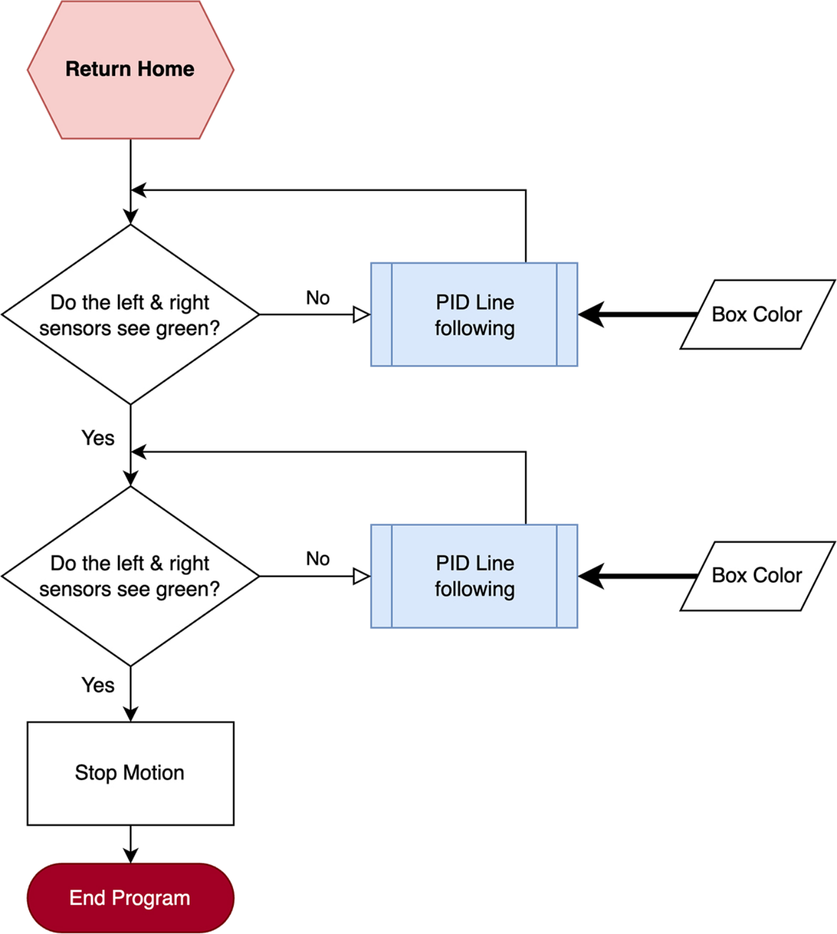
[picture p21: page 1]
