Max-Westerman/Integration-Final-Report/Images/flowchart/rotational_line_centering.pdf

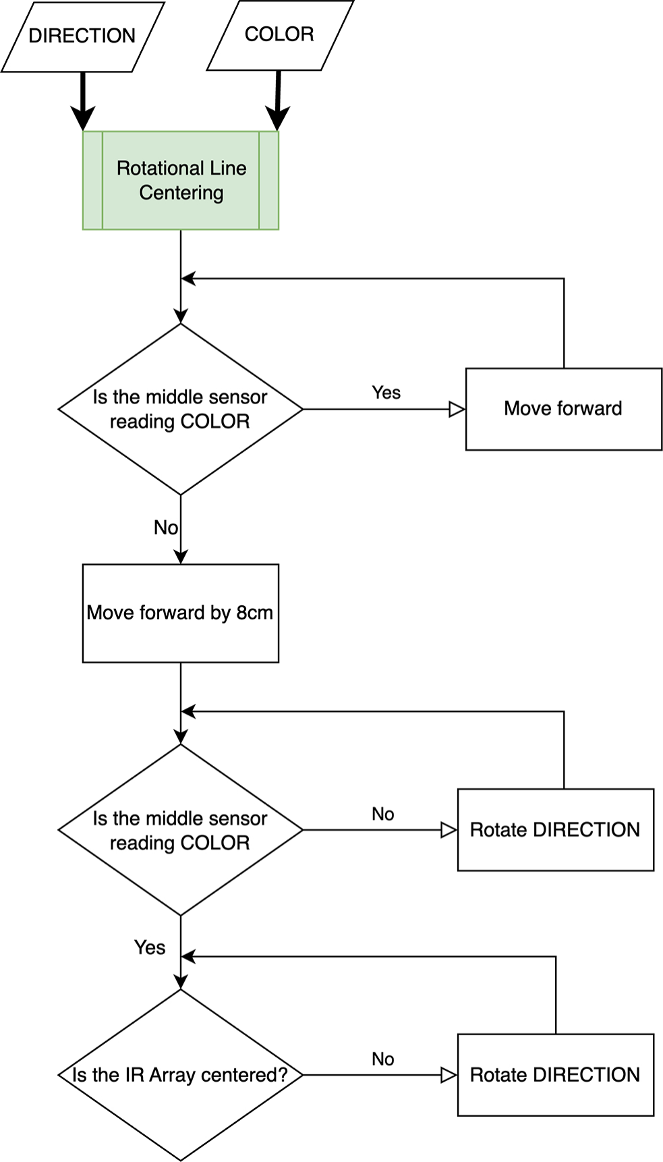
[picture p22: page 1]
