Max-Westerman/Integration-Final-Report/Images/flowchart/translational_line_centering.pdf

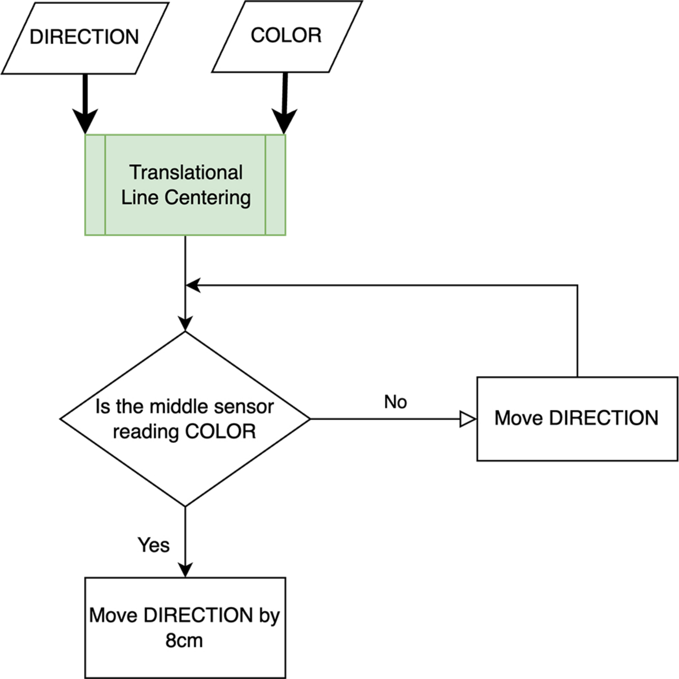
[picture p23: page 1]
