Max-Westerman/Integration-Final-Report/Images/Robot/robot_front_view_greyscale.pdf

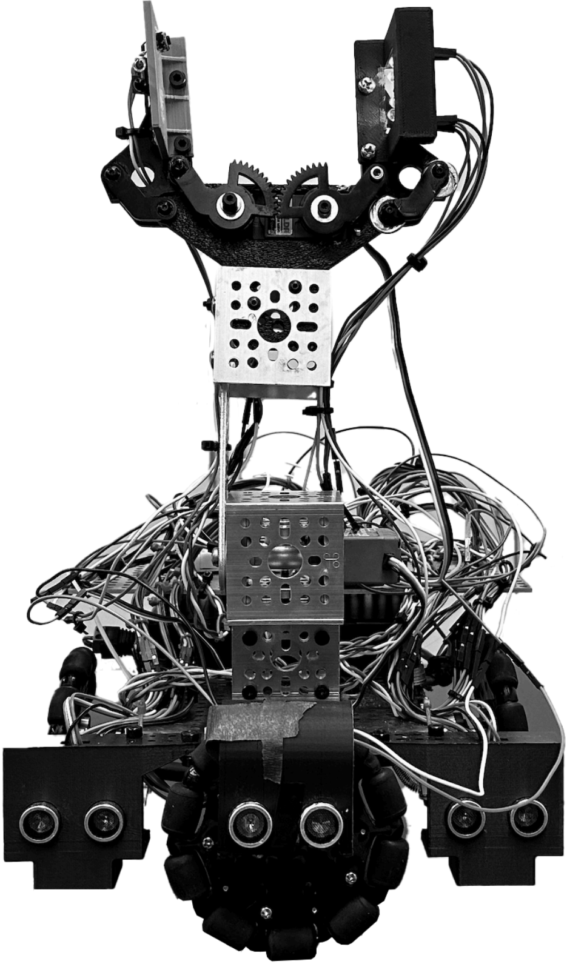
[picture p24: page 1]
