Max-Westerman/Integration-Final-Report/Images/Robot/robot_underside.pdf

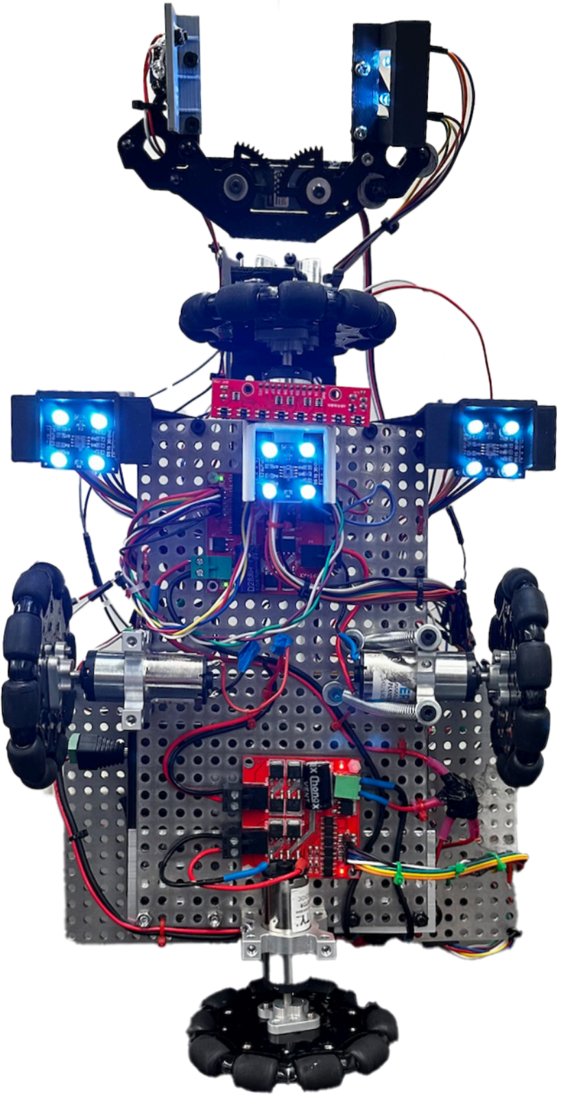
[picture p25: page 1]
