Max-Westerman/Integration-Final-Report/Images/PinoutMap/CS Map.PNG

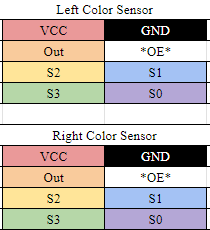
Images/PinoutMap/CS Map.PNG
