Max-Westerman/Integration-Final-Report/Images/PinoutMap/Pinout map.PNG

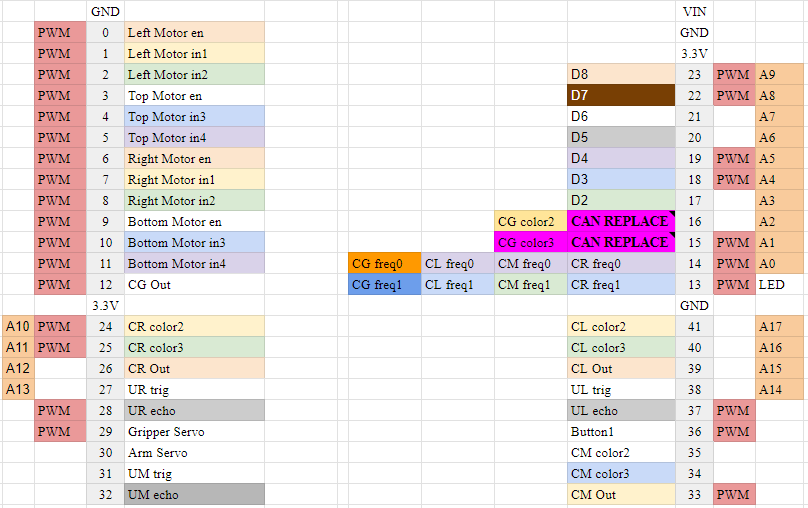
Images/PinoutMap/Pinout map.PNG
