Max-Westerman/Integration-Final-Report/Images/Cost/ir_cost.pdf

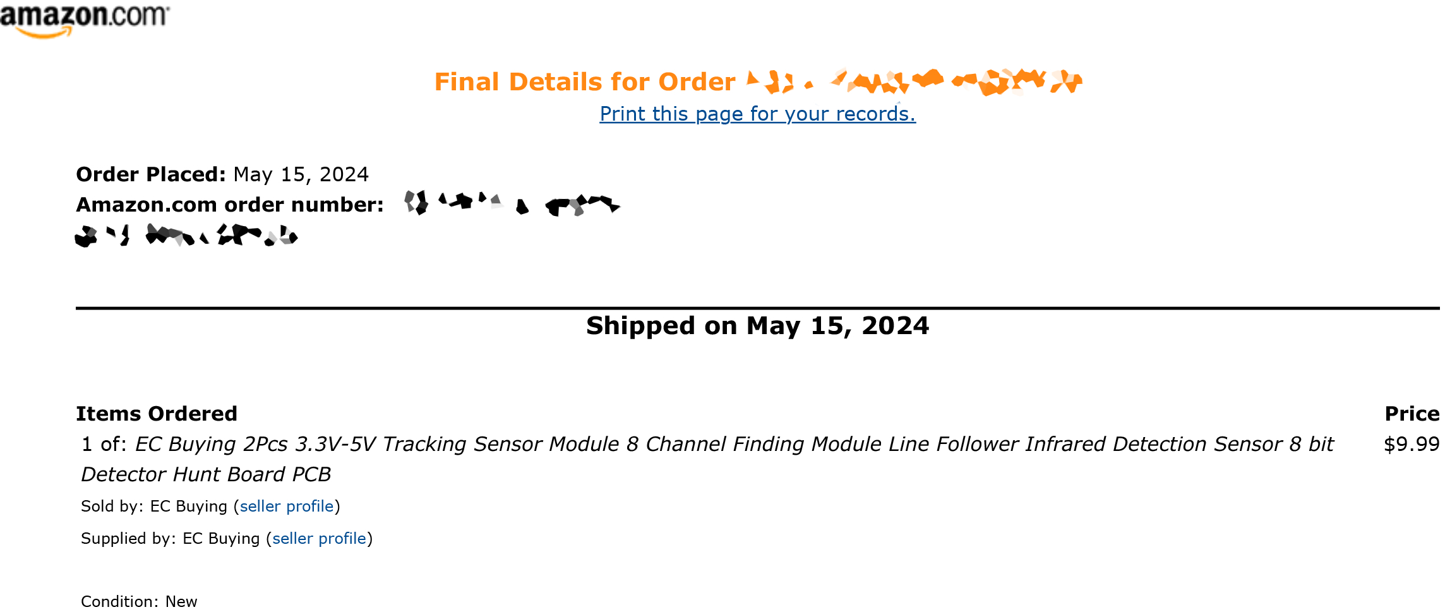
[picture p28: page 1]
