Max-Westerman/Integration-Final-Report/Images/Cost/slice3.pdf

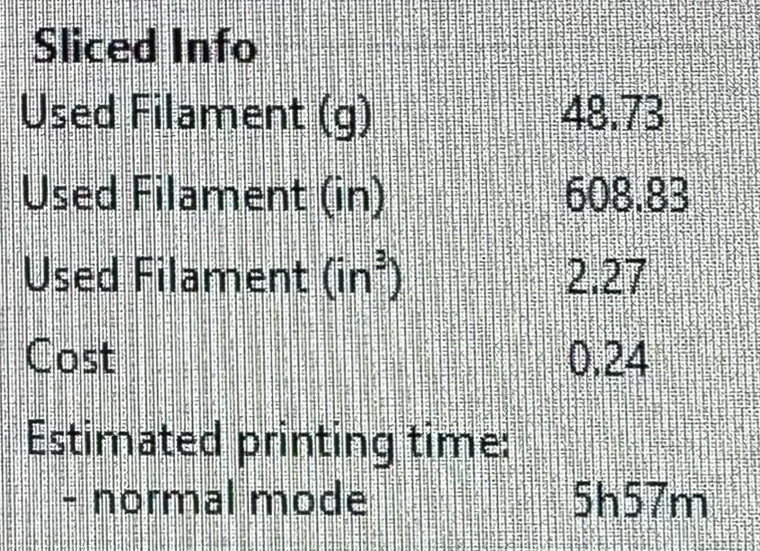
[picture p29: page 1]
