Max-Westerman/Integration-Final-Report/(list of files, cad)

Other CAD files:
Images/3D prints/USS-CS_Dual_new.SLDDRW
Images/3D prints/USS_Front ENGR Drawing.SLDDRW
