Max-Westerman/Integration-Final-Report/Images/3D prints/CS-IR_M ENGR Drawing.JPG

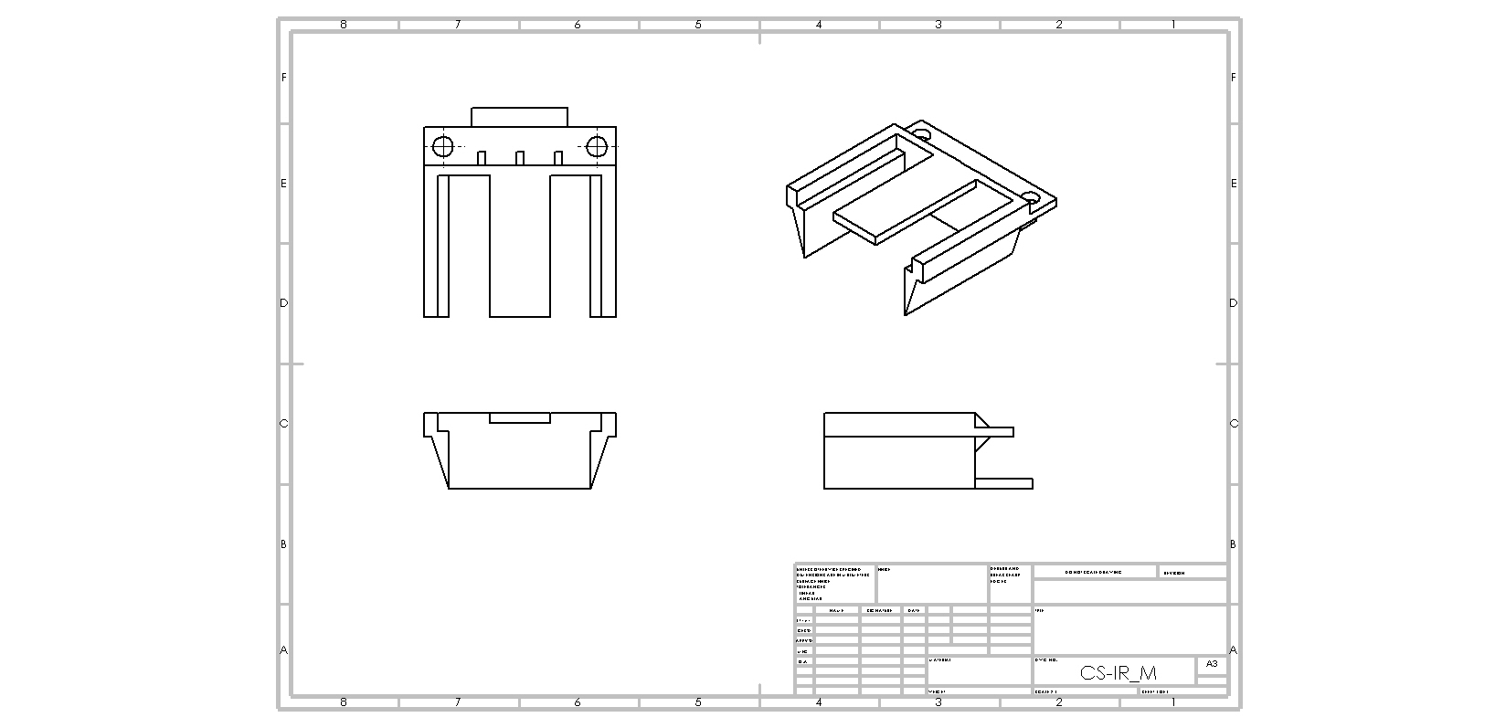
Images/3D prints/CS-IR_M ENGR Drawing.JPG
