Max-Westerman/Integration-Final-Report/Images/3D prints/CS-IR_M_new.PNG

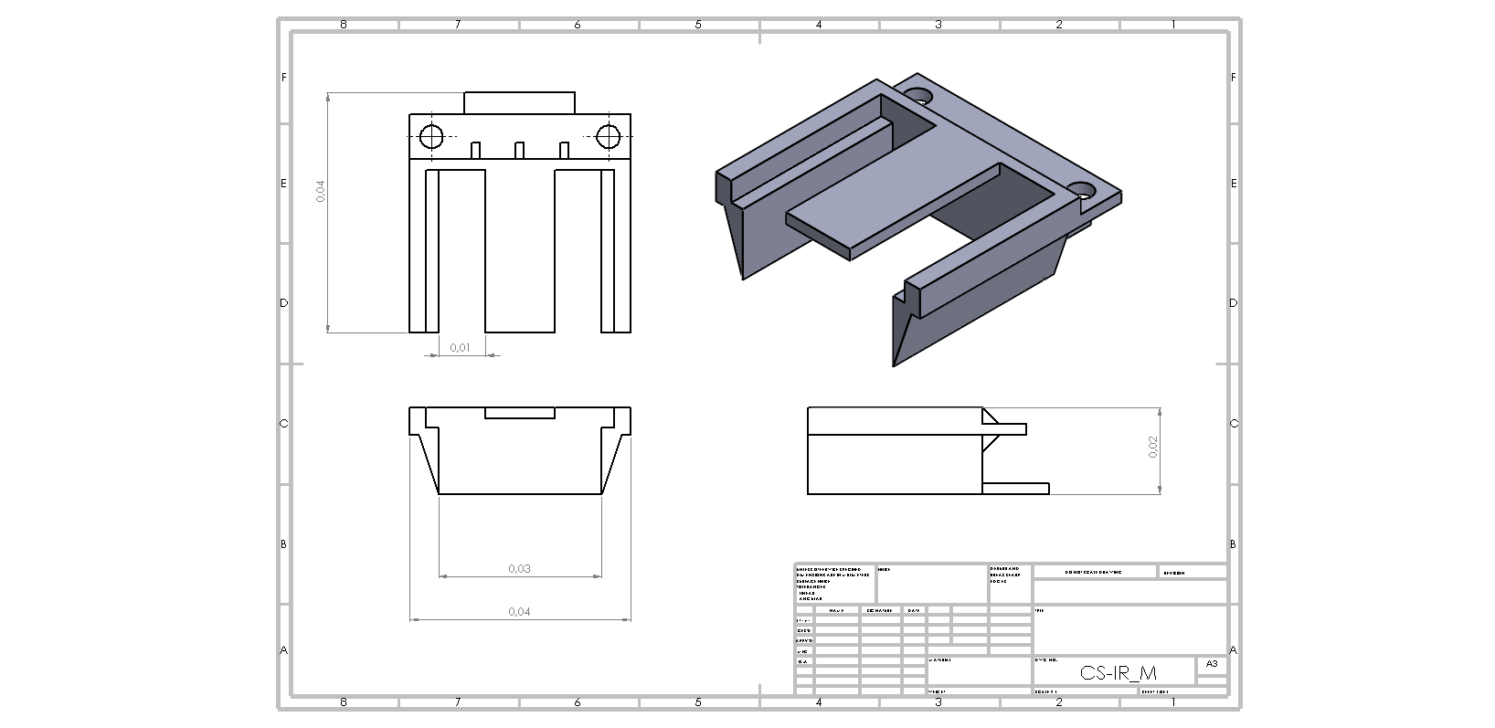
Images/3D prints/CS-IR_M_new.PNG
