Max-Westerman/Integration-Final-Report/Images/3D prints/GRPR_CS_Long ENGR Drawing.JPG

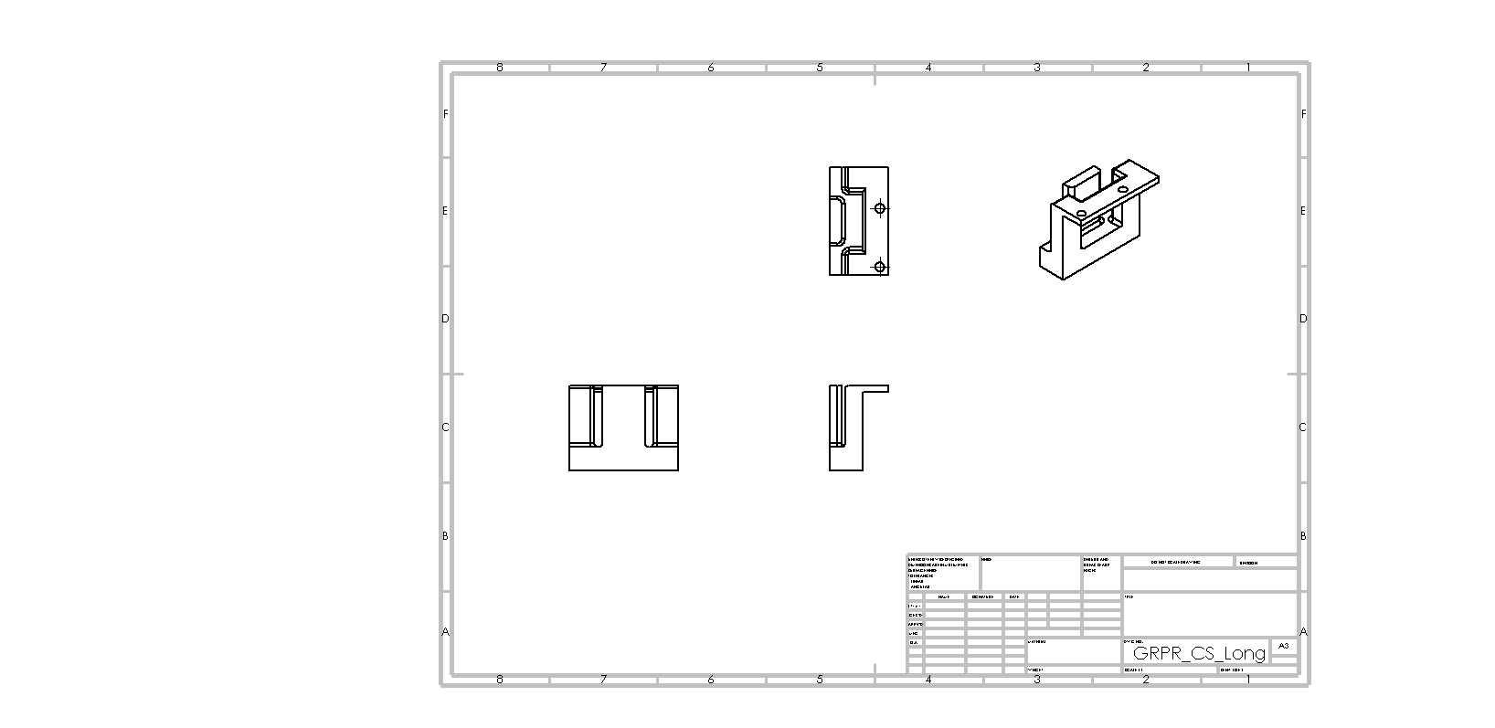
Images/3D prints/GRPR_CS_Long ENGR Drawing.JPG
