Max-Westerman/Integration-Final-Report/Images/3D prints/GRPR_CS_Long_new.PNG

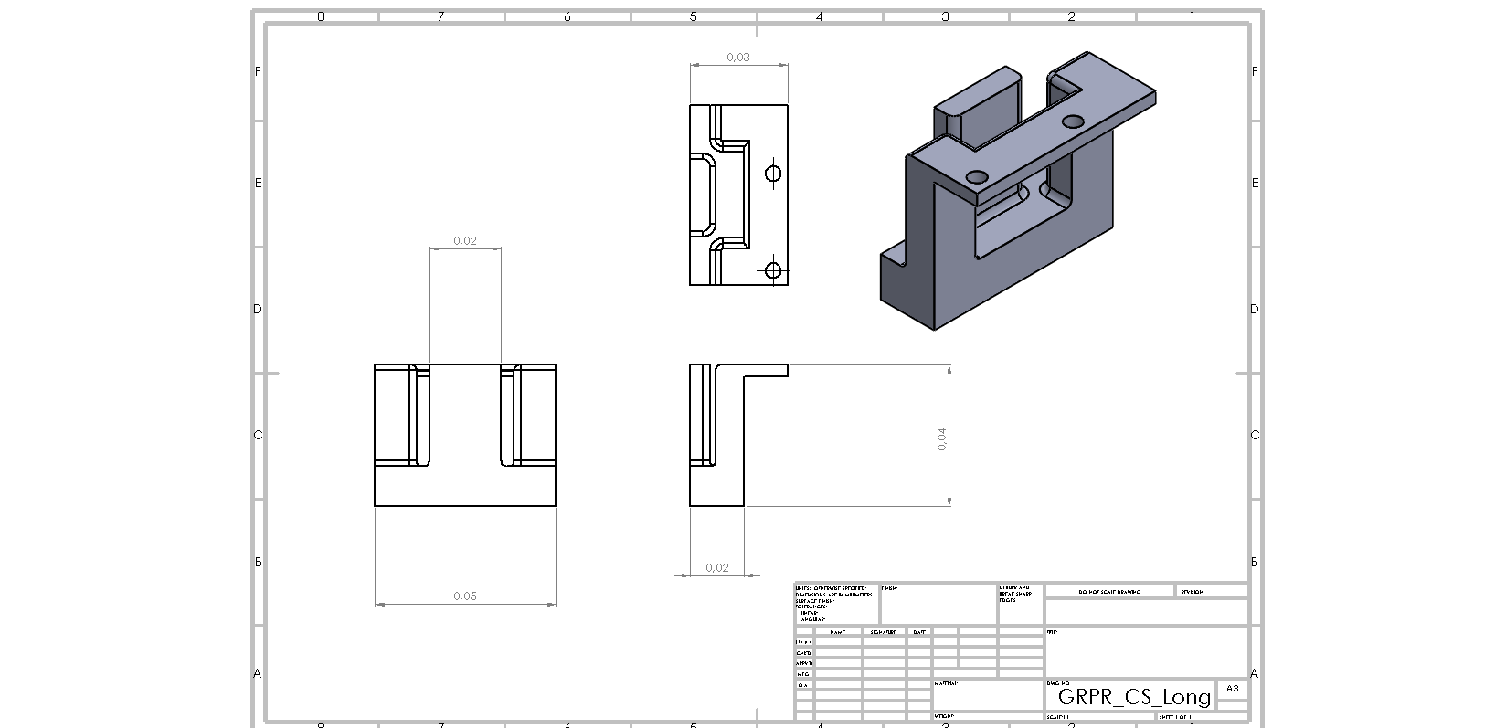
Images/3D prints/GRPR_CS_Long_new.PNG
