Max-Westerman/Integration-Final-Report/Images/3D prints/GRPR_DualButton ENGR Drawing.JPG

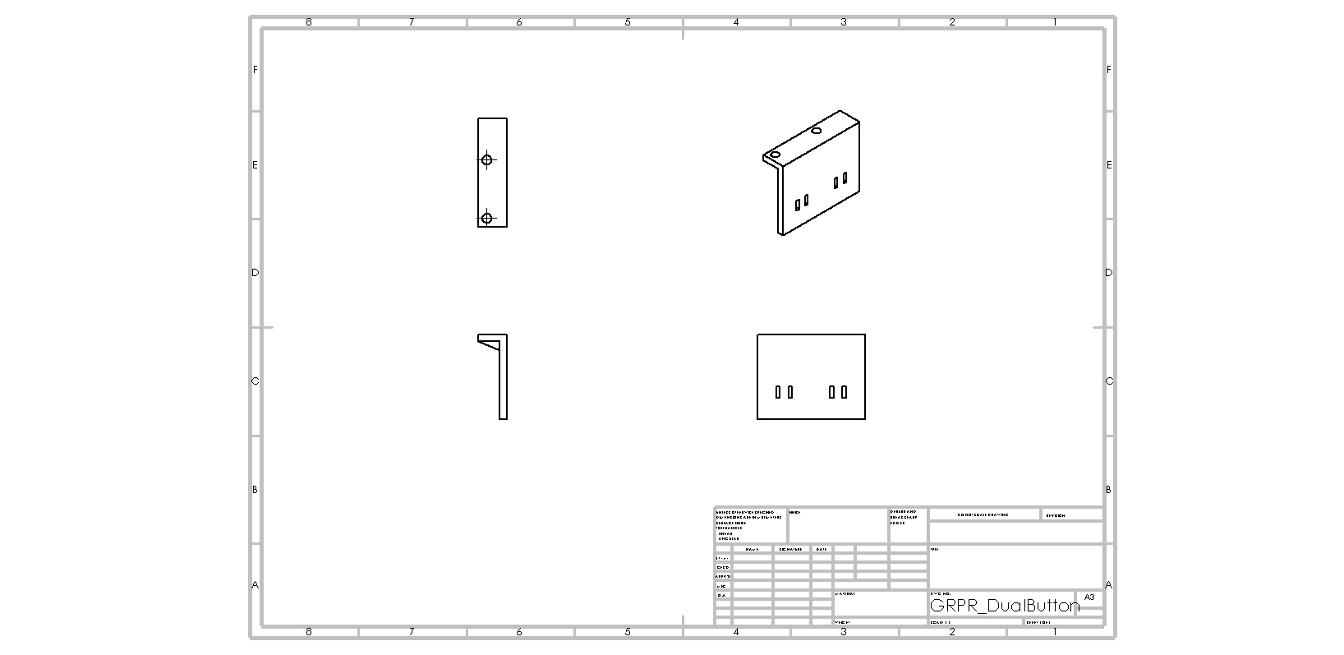
Images/3D prints/GRPR_DualButton ENGR Drawing.JPG
