Max-Westerman/Integration-Final-Report/Images/3D prints/GRPR_DualButton_new.PNG

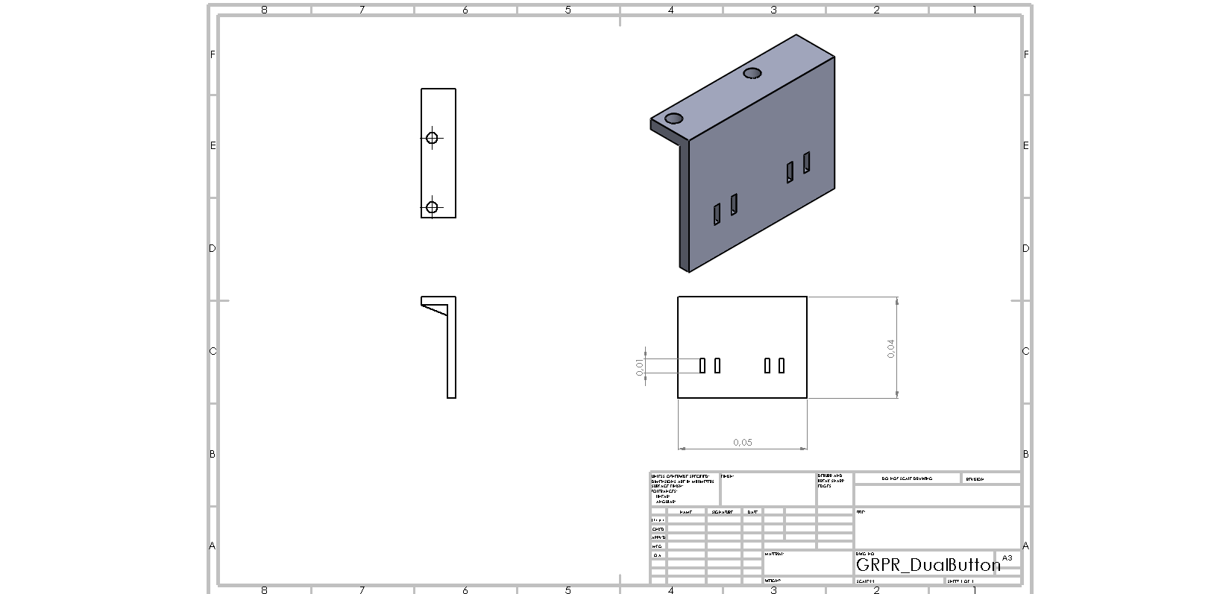
Images/3D prints/GRPR_DualButton_new.PNG
