Max-Westerman/Integration-Final-Report/Images/3D prints/USS-CS_Dual_new.PNG

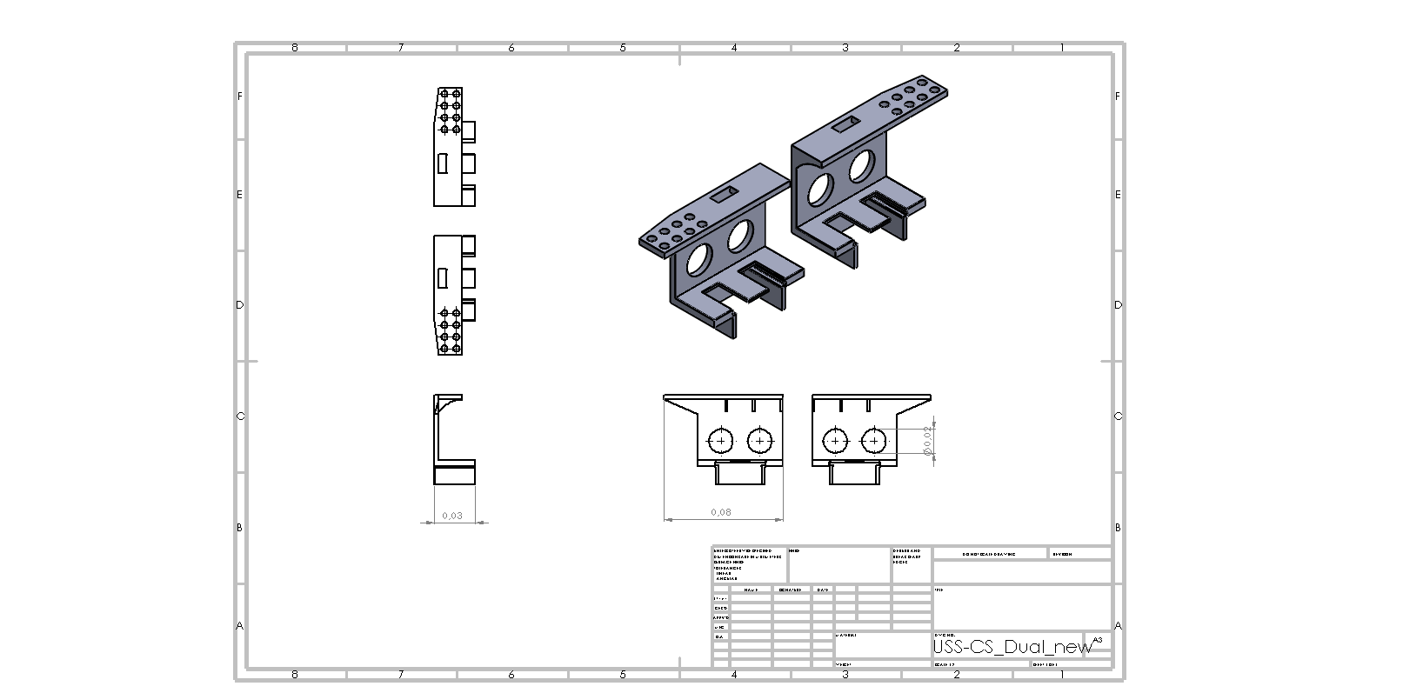
Images/3D prints/USS-CS_Dual_new.PNG
