Max-Westerman/Integration-Final-Report/Images/3D prints/USS_Front ENGR Drawing.JPG

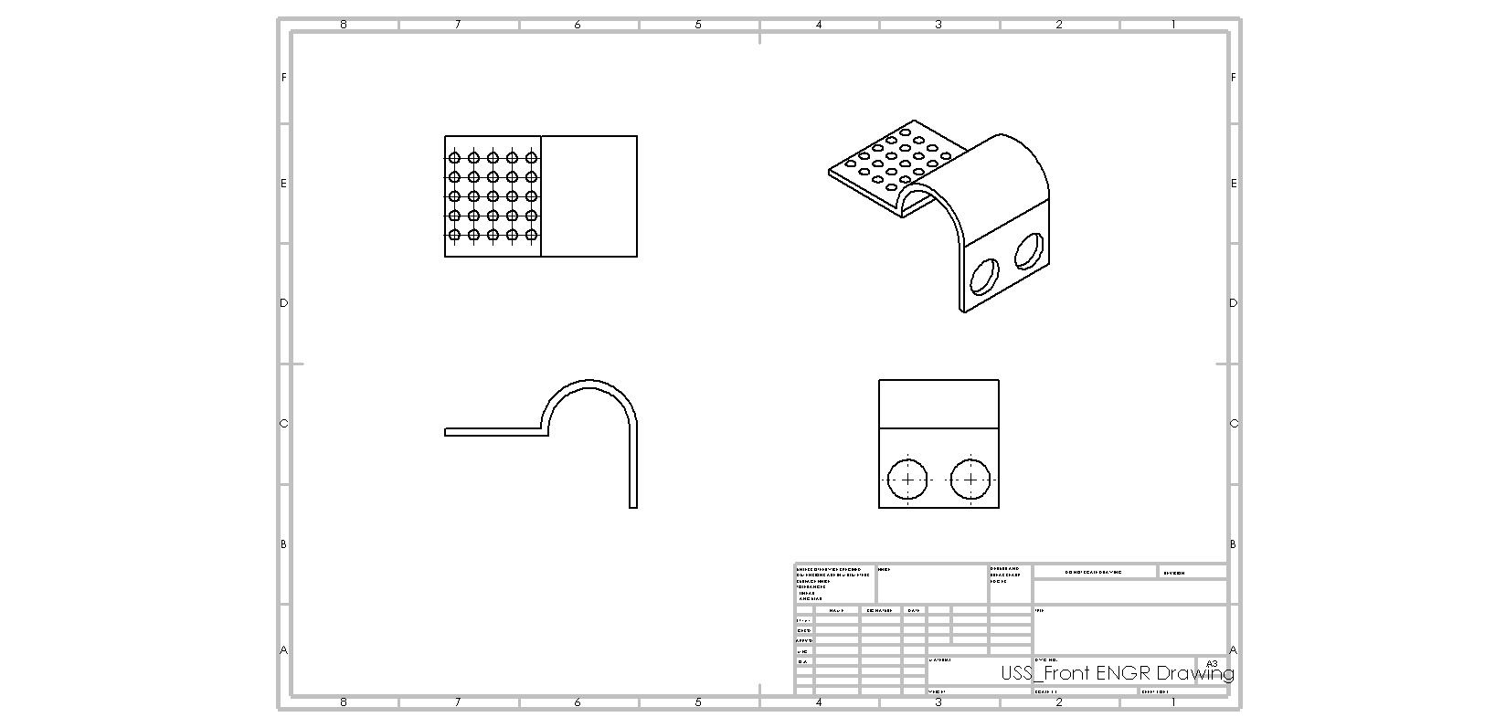
Images/3D prints/USS_Front ENGR Drawing.JPG
