Max-Westerman/Integration-Final-Report/Images/3D prints/USS_Front_new.PNG

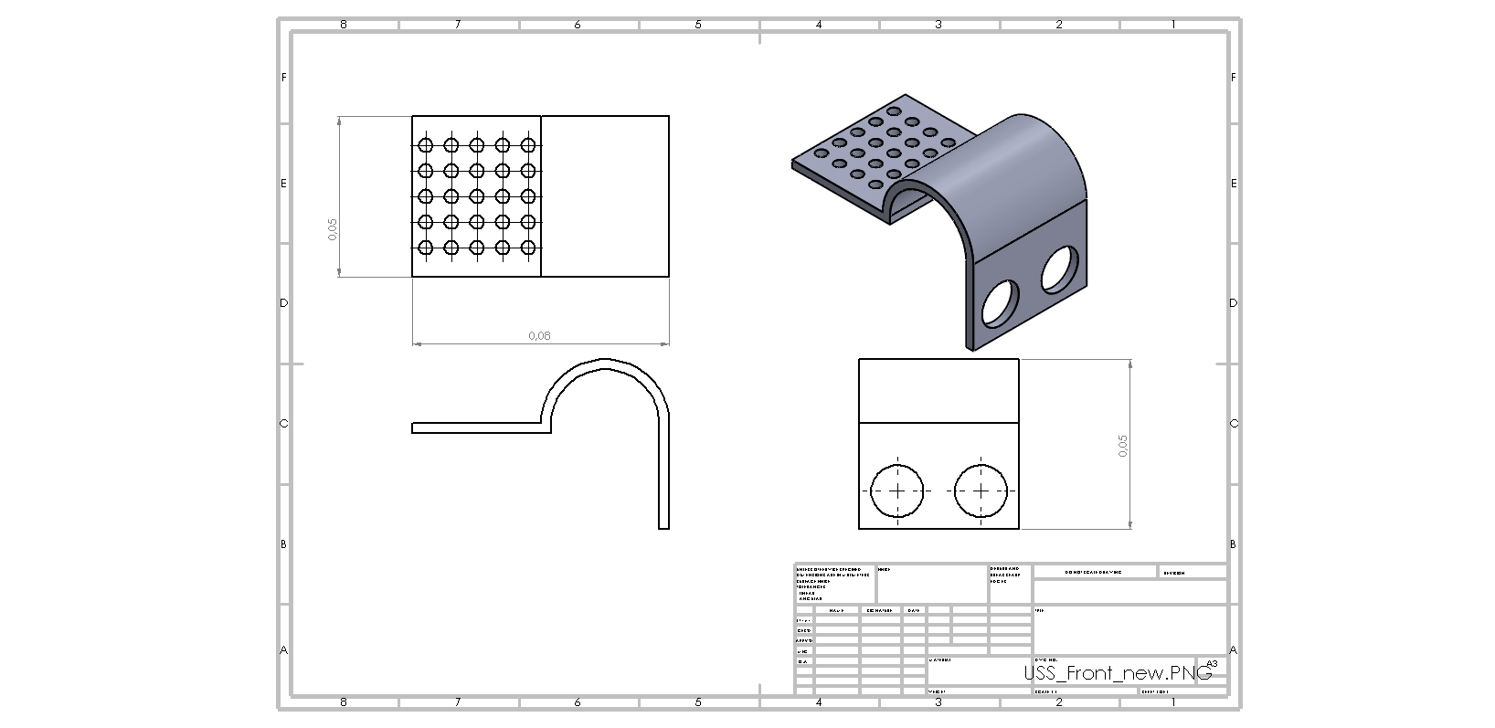
Images/3D prints/USS_Front_new.PNG
