Max-Westerman/Integration-Final-Report/Appendix/Calibration Data.tex

\documentclass[12pt]{report}
\usepackage{StyleSheets/main}
\begin{document}

\chapter{Calibration Data}\label{ch:calibration-data}

\section{Color Sensor Calibration Points}
\label{sc:color-sensor-points}
\input{Graphs/Color Sensor Calibration Graph}

\section{IR Array Calibration Points}
\label{sc:ir-array-points}
\input{Graphs/IR Array Calibration Graph}

\section{Motor Calibration Points}
\label{sc:motor-points}
\input{Graphs/Motor Calibration Graph}

\end{document}
