Max-Westerman/Integration-Final-Report/Graphs/Motor Calibration Graph.tex

\documentclass[12pt]{report}
\usepackage{GraphDefinitions}

\begin{document}

\begin{figure}[H]
\centering
\begin{tikzpicture}
    \begin{axis}[
        title = {Speed Percent ($\% \cdot 100$) vs Speed (cm/s)},
        width=1\textwidth, % Make the plot as wide as the subfigure
        height=0.45\textwidth, % Adjust the height for a wide format
        xlabel={Speed (cm/s)},
        ylabel={Speed Percent ($\% \cdot 100$)},
        legend pos=north west,
        ymin = -10,
        grid=both,
        grid style={line width=.1pt, draw=gray!10},
        major grid style={line width=.2pt,draw=gray!50},
        ]
        \MotorTrace{left}{speed_percent}{Left Speed Percent}{red}{solid}        
        \MotorTrace{right}{speed_percent}{Right Speed Percent}{green}{solid}
        \MotorTrace{top}{speed_percent}{Top Speed Percent}{blue}{solid}
        \MotorTrace{bottom}{speed_percent}{Bottom Speed Percent}{black}{solid}
    \end{axis}
\end{tikzpicture}
\label{speed-calibration-data}
\caption{Motor Calibration Data Regarding Speed Percent}
\end{figure}

\vspace{0.5cm} % Space between the subfigures

\begin{figure}[H]
\centering
\begin{tikzpicture}
    \begin{axis}[
        title = {PWM Percent ($\% \cdot 100$) vs Speed (cm/s)},
        width=\textwidth, % Make the plot as wide as the subfigure
        height=0.45\textwidth, % Adjust the height for a wide format
        xlabel={Speed (cm/s)},
        ylabel={PWM Percent ($\% \cdot 100$)},
        ymin = -10,
        legend pos=north west,
        grid=both,
        grid style={line width=.1pt, draw=gray!10},
        major grid style={line width=.2pt,draw=gray!50},
        ]
        \MotorTrace{left}{pwm_percent}{Left PWM Percent}{red}{solid}        
        \MotorTrace{right}{pwm_percent}{Right PWM Percent}{green}{solid}
        \MotorTrace{top}{pwm_percent}{Top PWM Percent}{blue}{solid}
        \MotorTrace{bottom}{pwm_percent}{Bottom PWM Percent}{black}{solid}
    \end{axis}
\end{tikzpicture}
\label{pwm-calibration-data}
\caption{Motor Calibration Data Regarding PWM Percent}
\end{figure}

\end{document}
