Max-Westerman/Integration-Final-Report/Graphs/SystemRiskManagementGraph.pdf

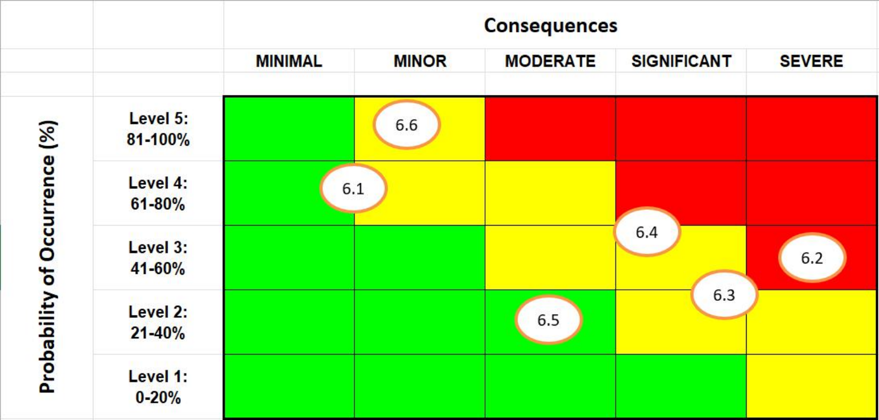
[picture p39: page 1]
