Max-Westerman/Integration-Final-Report/Images/Diagrams/robot_pinout.pdf

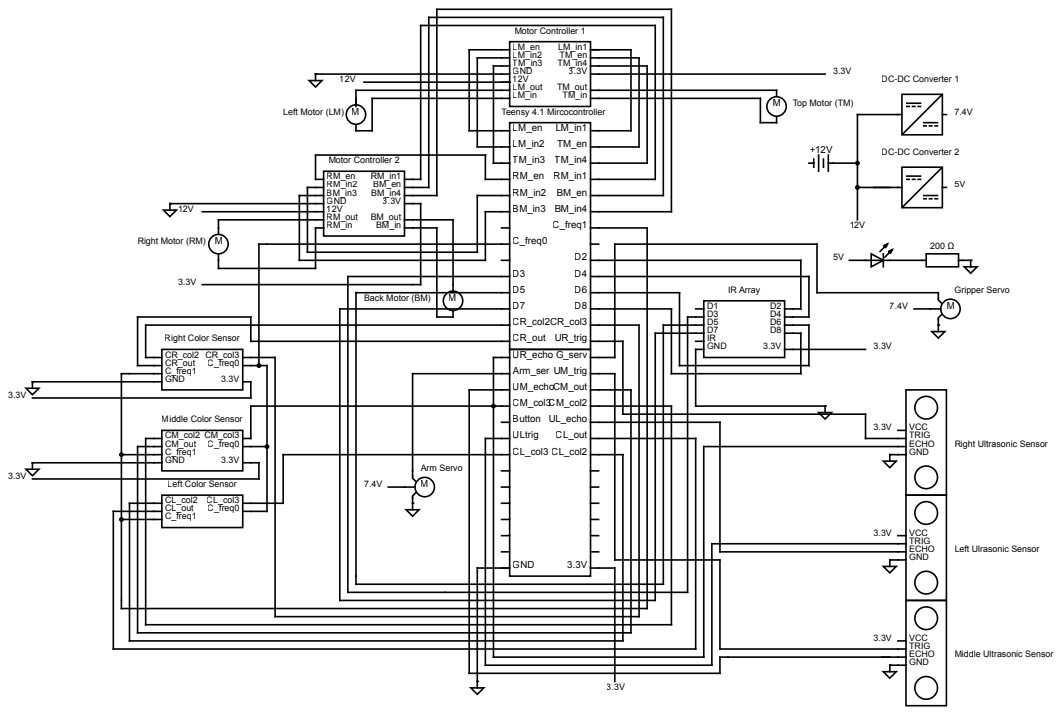
[picture p40: page 1]
