Max-Westerman/Integration-Final-Report/code/main/Initialization.h

/**
 * @file Initialization.h
 * @brief Header for initialization functions of various system components.
 *
 * This header file contains declarations and initialization functions for different
 * hardware components such as motors, sensors, and controllers used in a robotics system.
 * It sets up motors, ultrasonic sensors, color sensors, servos, and other devices to their
 * initial states and configurations.
 *
 * Created by: Max Westerman
 */

#ifndef INITIALIZATION_H
#define INITIALIZATION_H

#include <Arduino.h>
#include "sensors/ColorSensor.h"
#include "sensors/Motor.h"
#include "sensors/UltraSonic.h"
#include "sensors/MWServo.h"
#include "sensors/Button.h"
#include "sensors/IRSensorArray.h"
#include "controls/PIDController.h"
#include "controls/Utils.h"

#define VERTICAL_BOT_LENGTH 31.115
#define HORIZONTAL_BOT_LENGTH 23.1775
#define TOP_MOTOR_TO_IR_ARRAY_LENGTH 5.08
#define BOTTOM_MOTOR_TO_IR_ARRAY_LENGTH 25.4

extern ColorSensor leftColor, rightColor, gripperColor, middleColor;
extern Motor topMotor, bottomMotor, leftMotor, rightMotor;
extern UltraSonic rightSonic, leftSonic, middleSonic;
extern MWServo arm, gripper;
extern Button button;
extern PIDController pid;
extern IRSensorArray irArray;

/**
 * Initializes the Infrared Sensor Array with predetermined calibration values.
 */
void initIRArray() {

  int numSensors = 7;
  irArray.numSensors = numSensors;
  irArray.sensorPins = new int[numSensors]{A3, A4, A5, A6, A7, A8, A9};

  int* onValuesBlue = new int[numSensors]{942, 962, 961, 961, 958, 972, 981};
  int* onValuesGreen = new int[numSensors]{959, 970, 969, 972, 969, 978, 983};
  int* onValuesRed = new int[numSensors]{958, 974, 974, 976, 973, 982, 988};
  int* onValuesYellow = new int[numSensors]{928, 949, 948, 952, 947, 964, 977};
  int* offValues = new int[numSensors]{1005, 1006, 1007, 1006, 1007, 1008, 1007};
  
  irArray.setCalibrationValues(RED, onValuesRed, offValues);
  irArray.setCalibrationValues(GREEN, onValuesGreen, offValues);
  irArray.setCalibrationValues(BLUE, onValuesBlue, offValues);
  irArray.setCalibrationValues(YELLOW, onValuesYellow, offValues);
  irArray.initialize();
}

/**
 * Initializes the motors with specified calibration data and configurations.
 */
void initMotors(){

  // ==== TOP ====
  // Define calibration data
  std::vector<MotorCalibration> topCalibrationData = {
    {0, 25, 5.715},
    {6.67, 30, 8.5725},
    {20, 40, 14.3933333333333},
    {33.33, 50, 19.8966666666667},
    {46.67, 60, 24.6591666666667},
    {60, 70, 28.6279166666667},
    {73.33, 80, 32.86125},
    {86.67, 90, 37.2533333333333},
  };
  topMotor.enPin = 3;
  topMotor.in1Pin = 4;
  topMotor.in2Pin = 5;
  topMotor.label = "Top motor";
  topMotor.setCalibrationData(topCalibrationData);
  topMotor.initialize();

  // ==== BOTTOM ====
  std::vector<MotorCalibration> bottomCalibrationData = {
    {0, 25, 5.57106666666667},
    {6.67, 30, 8.18303333333333},
    {20, 40, 13.7244666666667},
    {33.33, 50, 19.2616666666667},
    {46.67, 60, 22.2779166666667},
    {60, 70, 24.8179166666667},
    {73.33, 80, 26.8816666666667},
    {86.67, 90, 30.6916666666667},
  };
  bottomMotor.enPin = 9;
  bottomMotor.in1Pin = 11;
  bottomMotor.in2Pin = 10;
  bottomMotor.label = "Bottom motor";
  bottomMotor.setCalibrationData(bottomCalibrationData);
  bottomMotor.initialize();

  // ==== LEFT ====

  std::vector<MotorCalibration> leftCalibrationData = {
    {0, 19, 0},
    {1.23, 20, 2.4},
    {7.41, 25, 9.398},
    {13.58, 30, 14.4},
    {25.93, 40, 20.16},
    {38.27, 50, 27.4},
    {50.62, 60, 33.6},
    {62.96, 70, 36.18},
    {75.31, 80, 41.6},
    {87.65, 90, 44.3},
    {100, 100, 54.4},
  };
  leftMotor.enPin = 0;
  leftMotor.in1Pin = 1;
  leftMotor.in2Pin = 2;
  leftMotor.label = "Left motor";
  leftMotor.setCalibrationData(leftCalibrationData);
  leftMotor.initialize();

  // ==== RIGHT ====
  std::vector<MotorCalibration> rightCalibrationData = {
    {0, 19, 0},
    {1.23, 20, 2.4},
    {7.41, 25, 9.398},
    {13.58, 30, 13.6},
    {25.93, 40, 18.36},
    {38.27, 50, 24.6},
    {50.62, 60, 31.32},
    {62.96, 70, 32.18},
    {75.31, 80, 38.2},
    {87.65, 90, 40.5},
    {100, 100, 48.48},
  };
  rightMotor.enPin = 6;
  rightMotor.in1Pin = 7;
  rightMotor.in2Pin = 8;
  rightMotor.label = "Right motor";
  rightMotor.setCalibrationData(rightCalibrationData);
  rightMotor.initialize();

}

/**
 * Initializes the button component by setting the designated pin mode.
 */
void initButtons(){
  button.pin = 36;
  button.initialize();
}

/**
 * Initializes the ultrasonic sensors, setting pin modes and default configurations.
 */
void initUltrasonicSensors(){

 // ==== LEFT ====

  leftSonic.trigPin = 38;
  leftSonic.echoPin = 37;
  leftSonic.soundDelay = 10;
  leftSonic.label = "Left UltraSonic Sensor";
  leftSonic.initialize();

 // ==== RIGHT ====

  rightSonic.trigPin = 27;
  rightSonic.echoPin = 28;
  rightSonic.soundDelay = 10;
  rightSonic.label = "Right UltraSonic Sensor";
  rightSonic.initialize();

 // ==== MIDDLE ====

  middleSonic.trigPin = 31;
  middleSonic.echoPin = 32;
  middleSonic.soundDelay = 10;
  middleSonic.label = "Middle UltraSonic Sensor";
  middleSonic.initialize();
}

/**
 * Initializes the servo motors, configuring the default angles and speed settings.
 */
void initServos(){

 // ==== GRIPPER ====

  gripper.pin = 29;
  gripper.base_angle = 0;
  gripper.max_angle = 60;
  gripper.initialize();
  gripper.speed = 100;
  gripper.move(100);
  
 // ==== ARM ====

  arm.pin = 30;
  arm.base_angle = 7;
  arm.max_angle = 54;
  arm.initialize();
  arm.speed = 80;
  arm.move(80);

}

/**
 * Initializes the PID controller used in the system.
 */
void initPID(){
  pid.initialize();
}

/**
 * Initializes color sensors, configuring them with frequency, pins, and label identifiers.
 */
void initColorSensors(){
  rightColor.output_frequency_0_pin = 14;
  rightColor.output_frequency_1_pin = 13;
  rightColor.color_selector_2_pin = 24;
  rightColor.color_selector_3_pin = 25;
  rightColor.out_pin = 26;

  rightColor.label = "Right";
  rightColor.frequency = 20;
  rightColor.initialize();

 // ======

  leftColor.output_frequency_0_pin = 14;
  leftColor.output_frequency_1_pin = 13;
  leftColor.color_selector_2_pin = 41;
  leftColor.color_selector_3_pin = 40;
  leftColor.out_pin = 39;

  leftColor.label = "Left";
  leftColor.frequency = 20;
  leftColor.initialize();

 // ======

  middleColor.output_frequency_0_pin = 14;
  middleColor.output_frequency_1_pin = 13;
  middleColor.color_selector_2_pin = 35;
  middleColor.color_selector_3_pin = 34;
  middleColor.out_pin = 33;
  middleColor.label = "Middle";
  middleColor.frequency = 20;
  middleColor.initialize();

 // ======

  gripperColor.output_frequency_0_pin = 14;
  gripperColor.output_frequency_1_pin = 13;
  gripperColor.color_selector_2_pin = 16;
  gripperColor.color_selector_3_pin = 15;
  gripperColor.out_pin = 12;
  gripperColor.label = "Gripper";
  gripperColor.frequency = 20;
  gripperColor.initialize();
}

/**
 * Initializes calibration points for color sensors. This includes RGB values for different
 * colors to aid in accurate detection.
 */
void initColorCalibrations(){

  middleColor.addCalibrationPoint(BLACK, 359, 300, 407);
  rightColor.addCalibrationPoint(BLACK, 617, 672, 768);
  leftColor.addCalibrationPoint(BLACK, 521, 546, 591);
  middleColor.addCalibrationPoint(BLACK, 358, 297, 403);
  rightColor.addCalibrationPoint(BLACK, 662, 700, 783);
  leftColor.addCalibrationPoint(BLACK, 539, 579, 635);
  middleColor.addCalibrationPoint(BLACK, 362, 304, 405);
  rightColor.addCalibrationPoint(BLACK, 622, 660, 754);
  leftColor.addCalibrationPoint(BLACK, 496, 535, 583);
  middleColor.addCalibrationPoint(BLACK, 349, 308, 421);
  rightColor.addCalibrationPoint(BLACK, 674, 729, 839);
  leftColor.addCalibrationPoint(BLACK, 613, 656, 714);
  middleColor.addCalibrationPoint(BLACK, 493, 512, 722);
  rightColor.addCalibrationPoint(BLACK, 680, 722, 850);
  leftColor.addCalibrationPoint(BLACK, 514, 550, 603);
  middleColor.addCalibrationPoint(BLACK, 585, 496, 650);
  rightColor.addCalibrationPoint(BLACK, 596, 570, 638);
  leftColor.addCalibrationPoint(BLACK, 528, 582, 598);
  middleColor.addCalibrationPoint(BLACK, 434, 375, 482);
  rightColor.addCalibrationPoint(BLACK, 602, 594, 664);
  leftColor.addCalibrationPoint(BLACK, 529, 624, 677);
  middleColor.addCalibrationPoint(BLACK, 438, 363, 490);
  rightColor.addCalibrationPoint(BLACK, 605, 606, 721);
  leftColor.addCalibrationPoint(BLACK, 628, 700, 760);
  middleColor.addCalibrationPoint(BLACK, 348, 294, 390);
  rightColor.addCalibrationPoint(BLACK, 540, 514, 599);
  leftColor.addCalibrationPoint(BLACK, 546, 593, 639);
  middleColor.addCalibrationPoint(BLACK, 405, 339, 457);
  rightColor.addCalibrationPoint(BLACK, 696, 690, 823);
  leftColor.addCalibrationPoint(BLACK, 569, 650, 721);
  middleColor.addCalibrationPoint(BLACK, 478, 410, 550);
  rightColor.addCalibrationPoint(BLACK, 803, 794, 935);
  leftColor.addCalibrationPoint(BLACK, 542, 608, 641);
  middleColor.addCalibrationPoint(BLACK, 414, 350, 466);
  rightColor.addCalibrationPoint(BLACK, 631, 598, 704);
  leftColor.addCalibrationPoint(BLACK, 552, 602, 639);
  middleColor.addCalibrationPoint(BLACK, 427, 365, 491);
  rightColor.addCalibrationPoint(BLACK, 613, 590, 669);
  leftColor.addCalibrationPoint(BLACK, 541, 620, 649);
  middleColor.addCalibrationPoint(BLACK, 388, 316, 423);
  rightColor.addCalibrationPoint(BLACK, 595, 580, 681);
  leftColor.addCalibrationPoint(BLACK, 662, 746, 794);
  middleColor.addCalibrationPoint(BLACK, 379, 312, 420);
  rightColor.addCalibrationPoint(BLACK, 587, 579, 671);
  leftColor.addCalibrationPoint(BLACK, 563, 588, 647);
  middleColor.addCalibrationPoint(BLACK, 327, 268, 358);
  rightColor.addCalibrationPoint(BLACK, 418, 387, 458);
  leftColor.addCalibrationPoint(BLACK, 582, 679, 727);
  middleColor.addCalibrationPoint(BLACK, 389, 323, 454);
  rightColor.addCalibrationPoint(BLACK, 650, 678, 808);
  leftColor.addCalibrationPoint(BLACK, 551, 609, 642);
  middleColor.addCalibrationPoint(BLACK, 445, 362, 487);
  rightColor.addCalibrationPoint(BLACK, 706, 745, 848);
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
  middleColor.addCalibrationPoint(BLACK, 329, 262, 352);
  middleColor.addCalibrationPoint(BLACK, 379, 310, 424);
  middleColor.addCalibrationPoint(BLACK, 332, 272, 367);
  middleColor.addCalibrationPoint(BLACK, 368, 301, 407);
  middleColor.addCalibrationPoint(BLACK, 337, 271, 371);
  middleColor.addCalibrationPoint(BLACK, 339, 272, 371);

  rightColor.addCalibrationPoint(WHITE, 118, 114, 130);
  rightColor.addCalibrationPoint(WHITE, 112, 106, 122);
  rightColor.addCalibrationPoint(WHITE, 114, 107, 123);
  rightColor.addCalibrationPoint(WHITE, 131, 124, 142);
  rightColor.addCalibrationPoint(WHITE, 152, 134, 158);
  middleColor.addCalibrationPoint(WHITE, 101, 80, 105);
  middleColor.addCalibrationPoint(WHITE, 97, 78, 102);
  middleColor.addCalibrationPoint(WHITE, 104, 81, 108);
  middleColor.addCalibrationPoint(WHITE, 105, 84, 110);
  middleColor.addCalibrationPoint(WHITE, 96, 78, 102);
  leftColor.addCalibrationPoint(WHITE, 118, 119, 129);
  leftColor.addCalibrationPoint(WHITE, 117, 118, 128);
  leftColor.addCalibrationPoint(WHITE, 118, 120, 130);
  leftColor.addCalibrationPoint(WHITE, 126, 118, 131);
  leftColor.addCalibrationPoint(WHITE, 131, 117, 131);
}
#endif
