Max-Westerman/Integration-Final-Report/(commit log)

2024-06-07 Initial Overleaf Import
    [bottom_calibration_data.csv, gripperColor.csv, leftColor.csv, left_calibration_data.csv, middleColor.csv, rightColor.csv, right_calibration_data.csv, sensor_calibration_data.csv]
2024-06-09 Fit some code to LaTeX margin. Added chapters.
    [bottom_calibration_data.csv, gripperColor.csv, leftColor.csv, left_calibration_data.csv, middleColor.csv, rightColor.csv, right_calibration_data.csv, sensor_calibration_data.csv]
2024-06-09 Removed "Ignore" Directory
    [bottom_calibration_data.csv, gripperColor.csv, leftColor.csv, left_calibration_data.csv, middleColor.csv, rightColor.csv, right_calibration_data.csv, sensor_calibration_data.csv]
2024-06-11 Major changes.
    [USS_Front ENGR Drawing.SLDDRW]
2024-06-12 Finalized report
    [USS-CS_Dual_new.SLDDRW]
